rotorit/Adapto/Pictures/AluFrame/20120826_175629.jpg

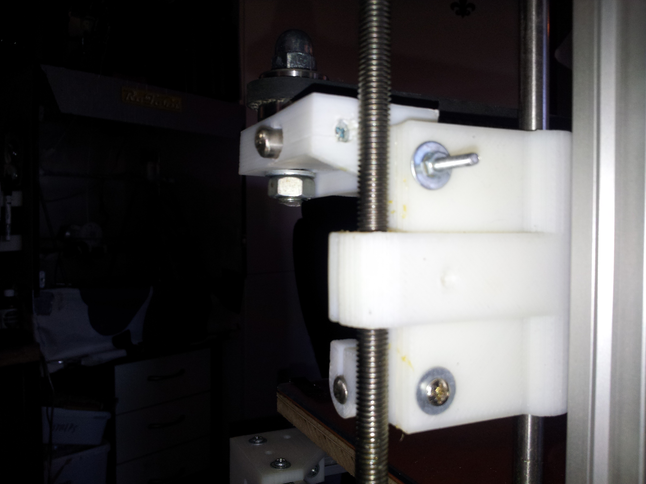
Pictures/AluFrame/20120826_175629.jpg
