rotorit/Adapto/Pictures/WoodenFrame1/20120906_165929.jpg

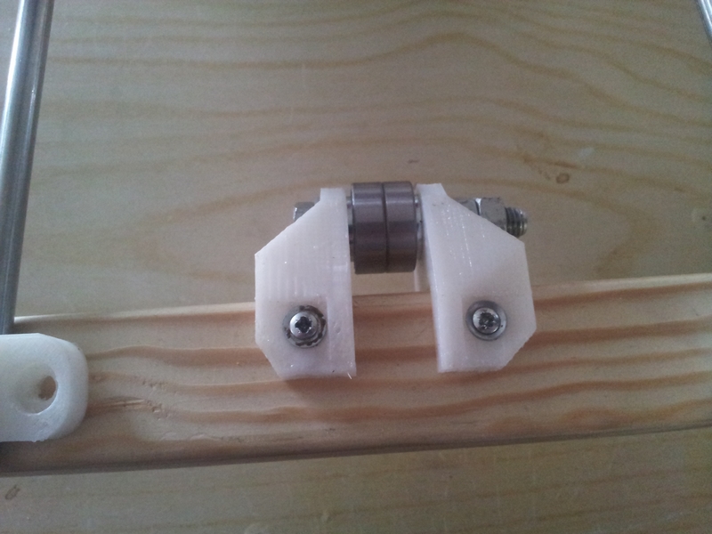
Pictures/WoodenFrame1/20120906_165929.jpg
