rotorit/Adapto/Pictures/AluFrame/20120826_175411.jpg

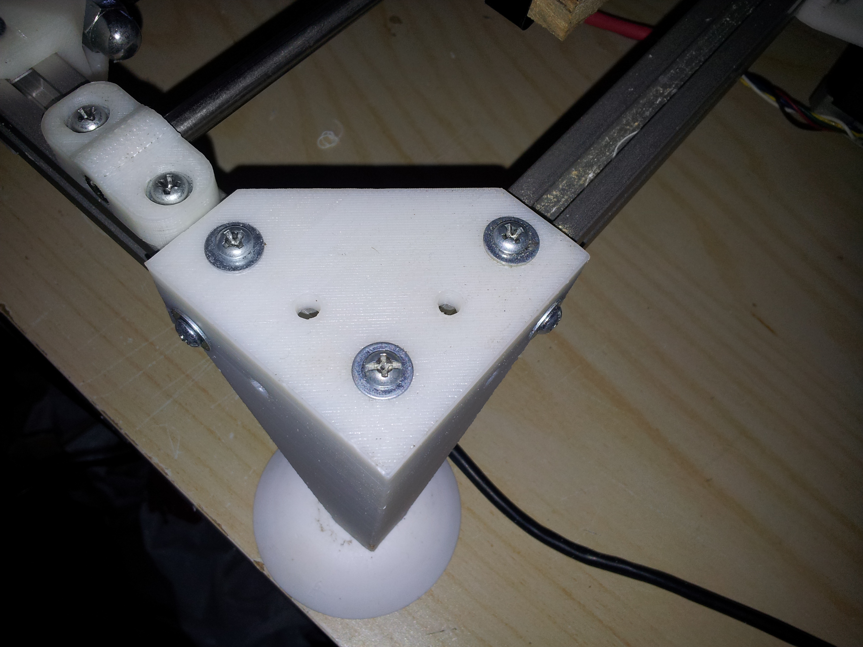
Pictures/AluFrame/20120826_175411.jpg
