rotorit/Adapto/Pictures/AluFrame/20120826_175428.jpg

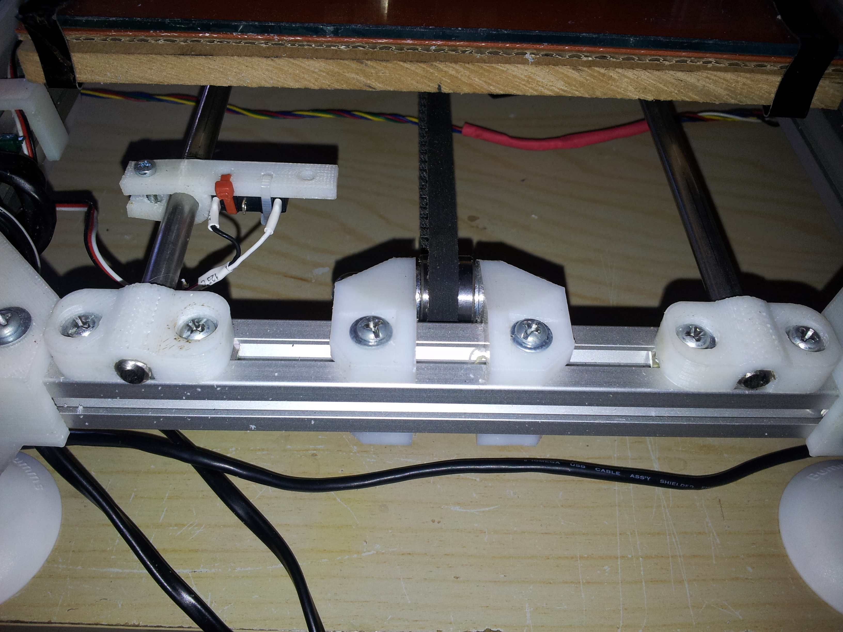
Pictures/AluFrame/20120826_175428.jpg
