rotorit/Adapto/Pictures/AluFrame/20120826_175446.jpg

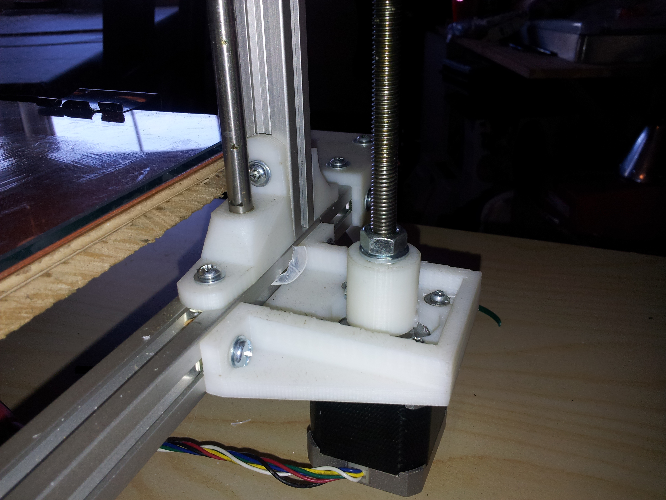
Pictures/AluFrame/20120826_175446.jpg
