rotorit/Adapto/Pictures/AluFrame/20120826_175456.jpg

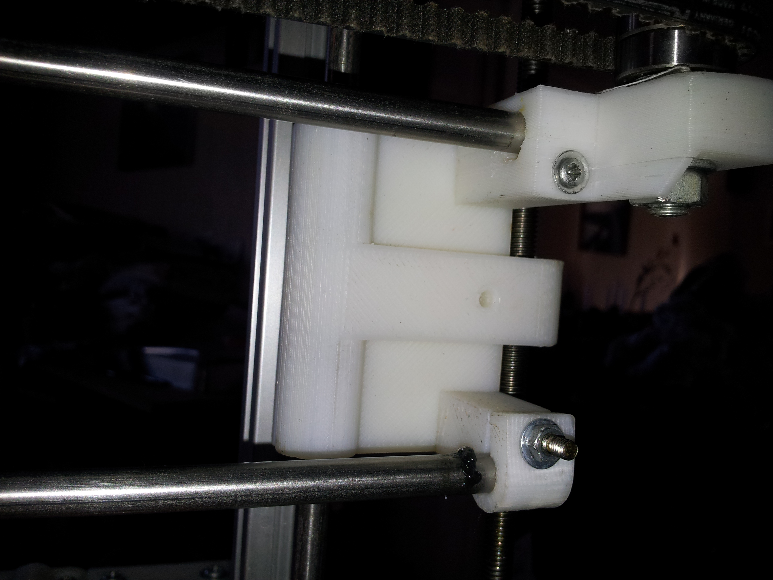
Pictures/AluFrame/20120826_175456.jpg
