rotorit/Adapto/Pictures/AluFrame/20120826_175528.jpg

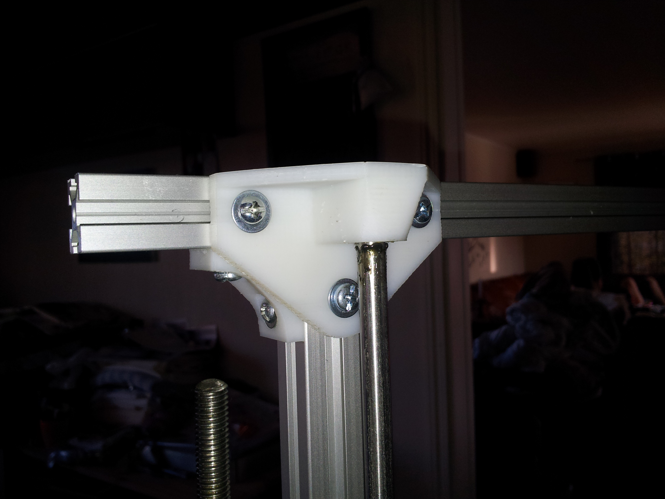
Pictures/AluFrame/20120826_175528.jpg
