rotorit/Adapto/Pictures/AluFrame/20120826_175540.jpg

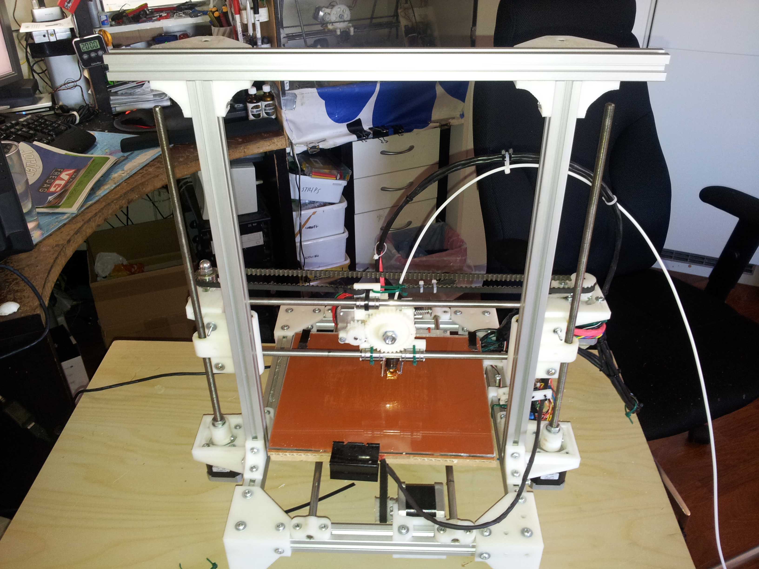
Pictures/AluFrame/20120826_175540.jpg
