rotorit/Adapto/Pictures/AluFrame/20120826_175548.jpg

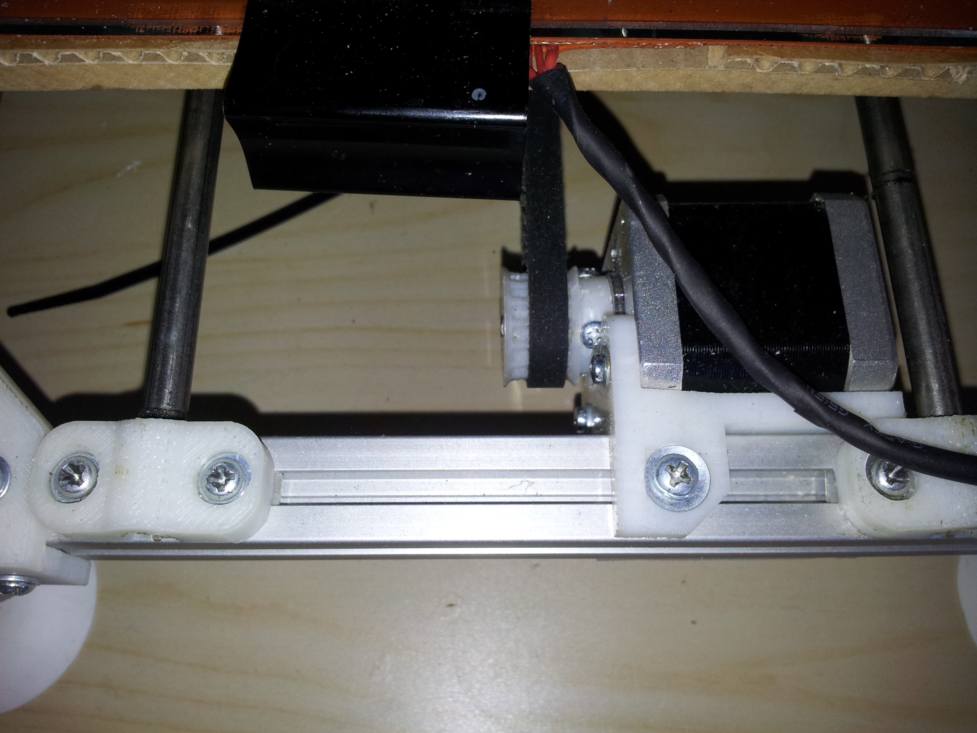
Pictures/AluFrame/20120826_175548.jpg
