rotorit/Adapto/Pictures/AluFrame/20120826_175600.jpg

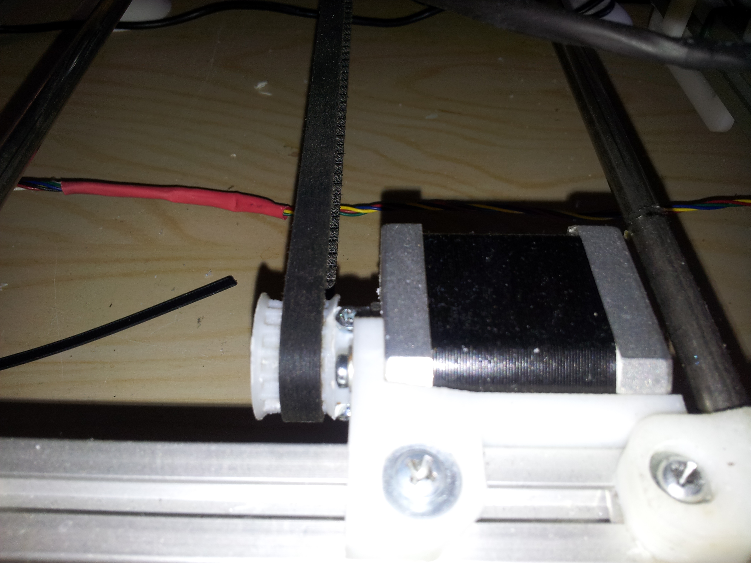
Pictures/AluFrame/20120826_175600.jpg
