rotorit/Adapto/Pictures/AluFrame/20120826_175611.jpg

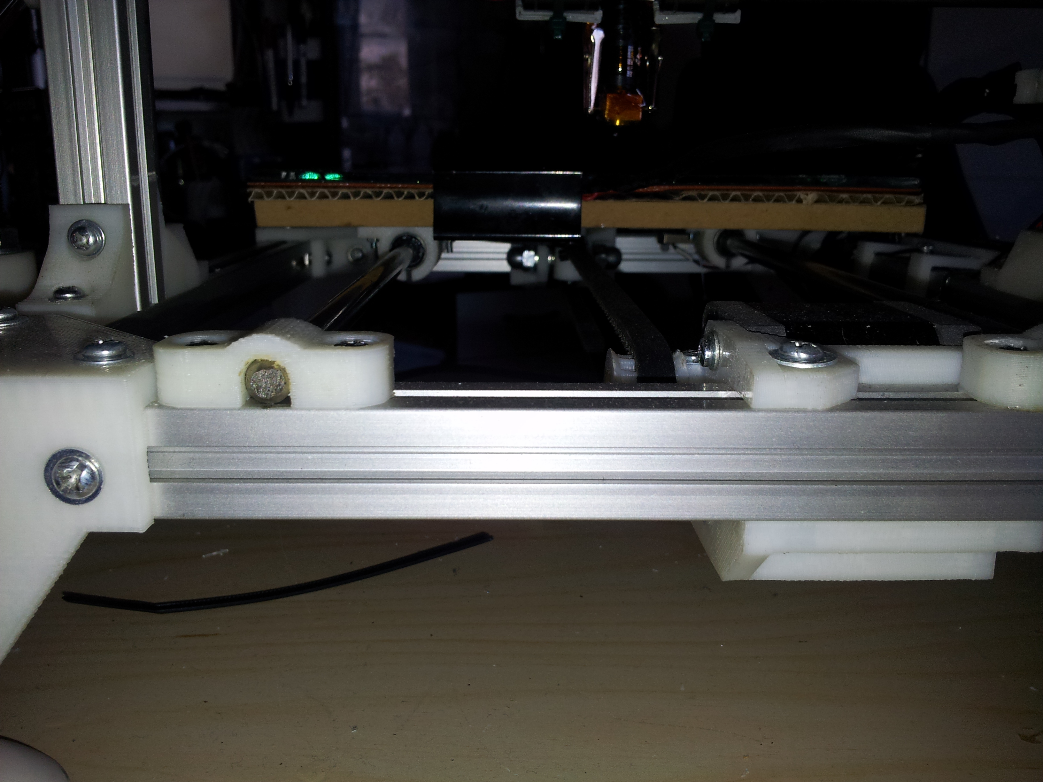
Pictures/AluFrame/20120826_175611.jpg
