rotorit/Adapto/Pictures/AluFrame/20120826_175620.jpg

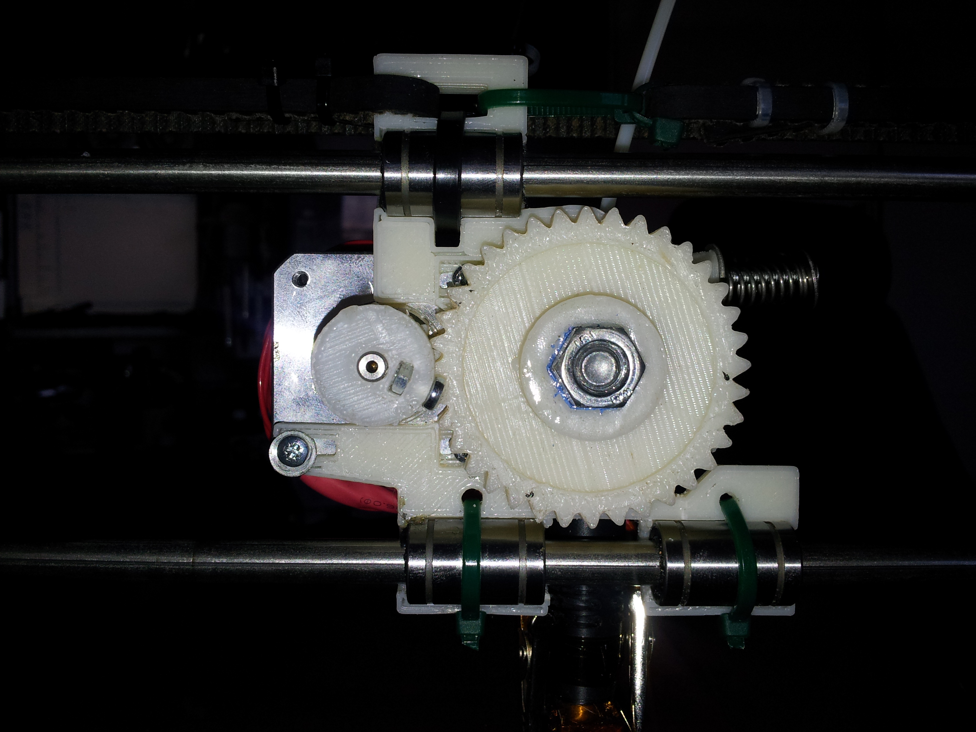
Pictures/AluFrame/20120826_175620.jpg
