rotorit/Adapto/Pictures/AluFrame/20120826_175636.jpg

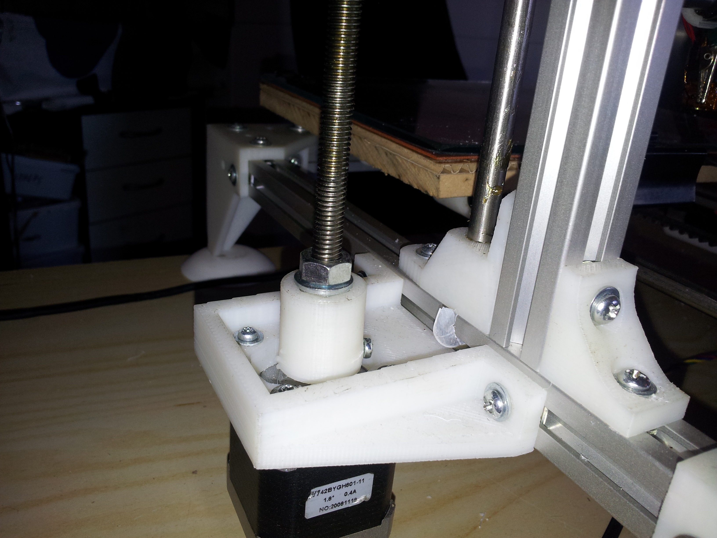
Pictures/AluFrame/20120826_175636.jpg
