rotorit/Adapto/Pictures/AluFrame/20120826_175650.jpg

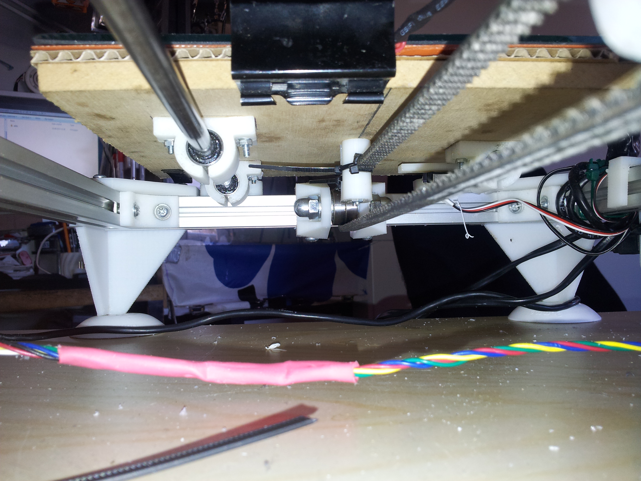
Pictures/AluFrame/20120826_175650.jpg
