rotorit/Adapto/Pictures/AluFrame/20120826_175700.jpg

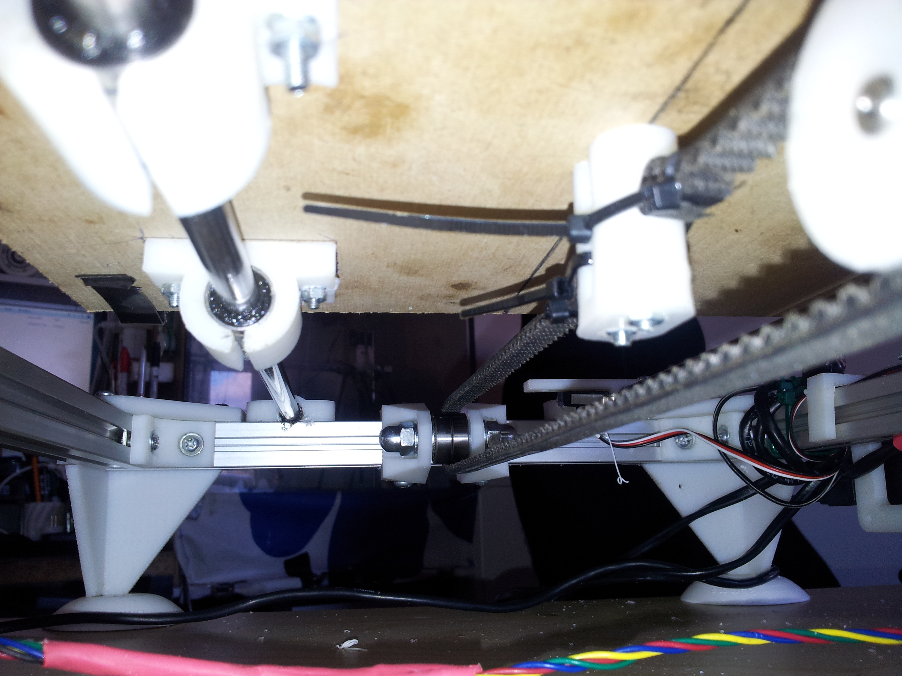
Pictures/AluFrame/20120826_175700.jpg
