rotorit/Adapto/Pictures/AluFrame/20120826_175709.jpg

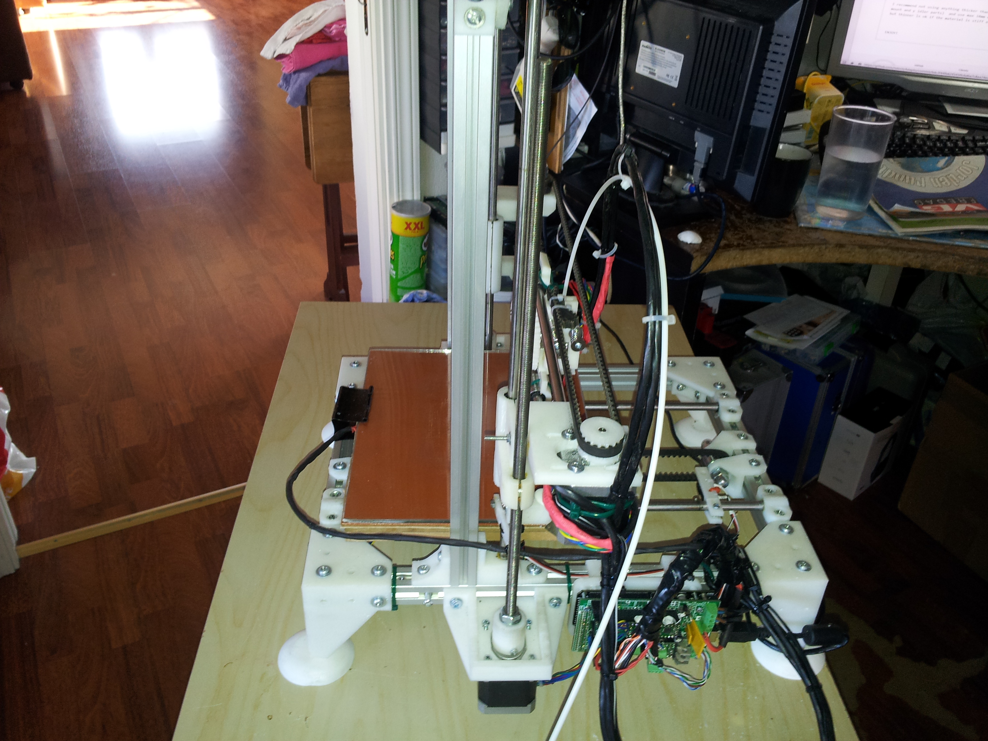
Pictures/AluFrame/20120826_175709.jpg
