rotorit/Adapto/Pictures/AluFrame/20120826_175718.jpg

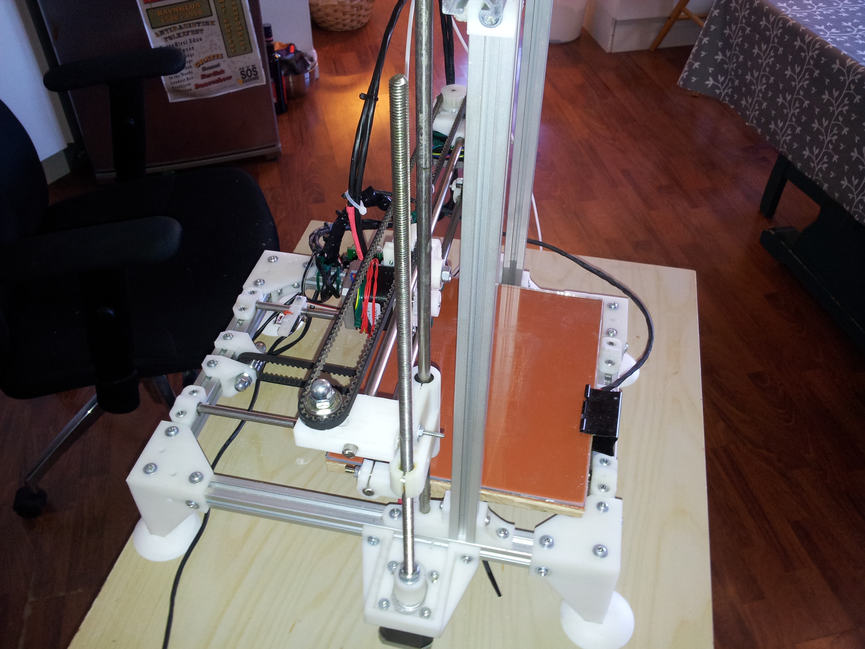
Pictures/AluFrame/20120826_175718.jpg
