rotorit/Adapto/Pictures/AluFrame/20120906_141601.jpg

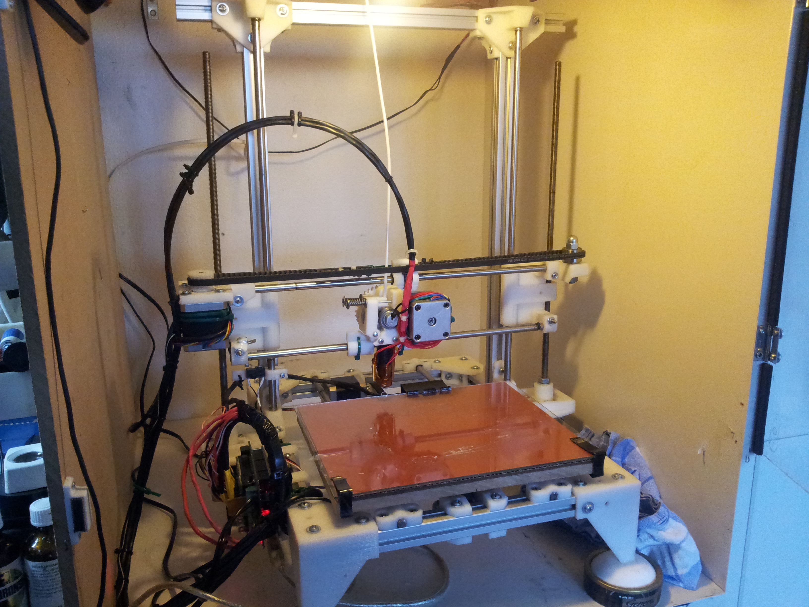
Pictures/AluFrame/20120906_141601.jpg
