rotorit/Adapto/Pictures/WoodenFrame1/20120906_165900.jpg

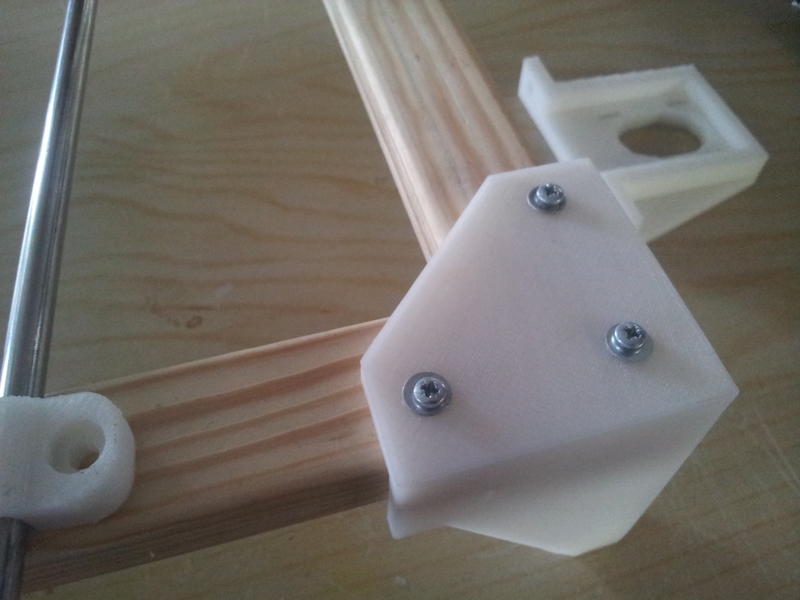
Pictures/WoodenFrame1/20120906_165900.jpg
