rotorit/Adapto/Pictures/WoodenFrame1/20120906_165909.jpg

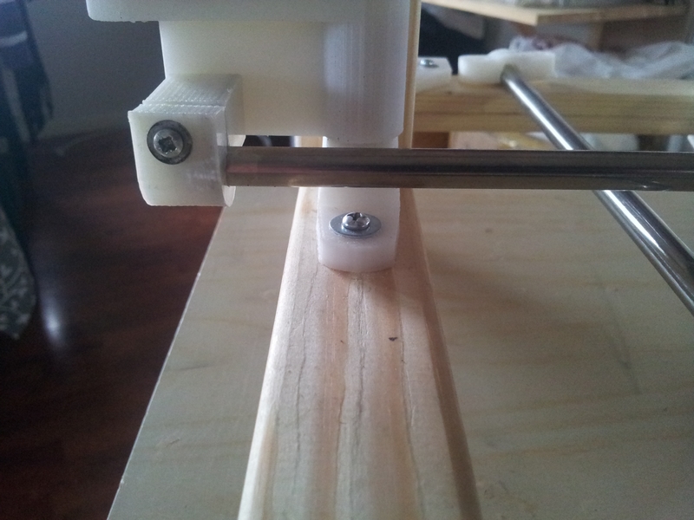
Pictures/WoodenFrame1/20120906_165909.jpg
