rotorit/Adapto/Pictures/WoodenFrame1/20120906_165917.jpg

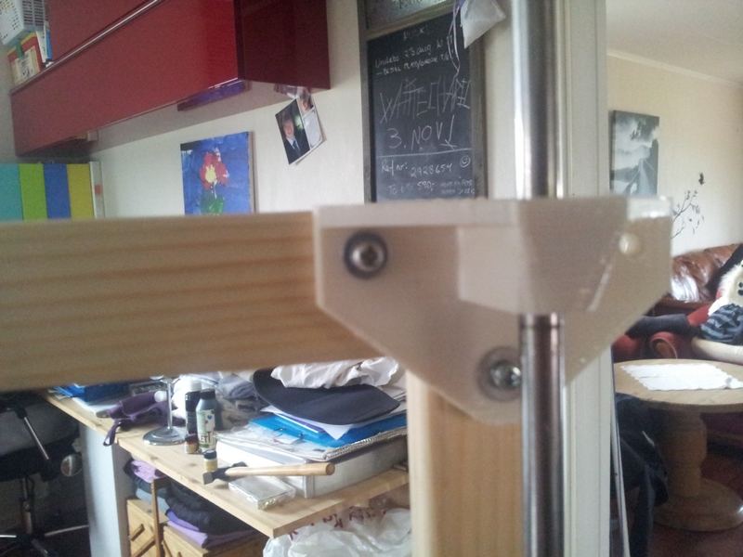
Pictures/WoodenFrame1/20120906_165917.jpg
