rotorit/Adapto/Pictures/WoodenFrame1/20120906_165955.jpg

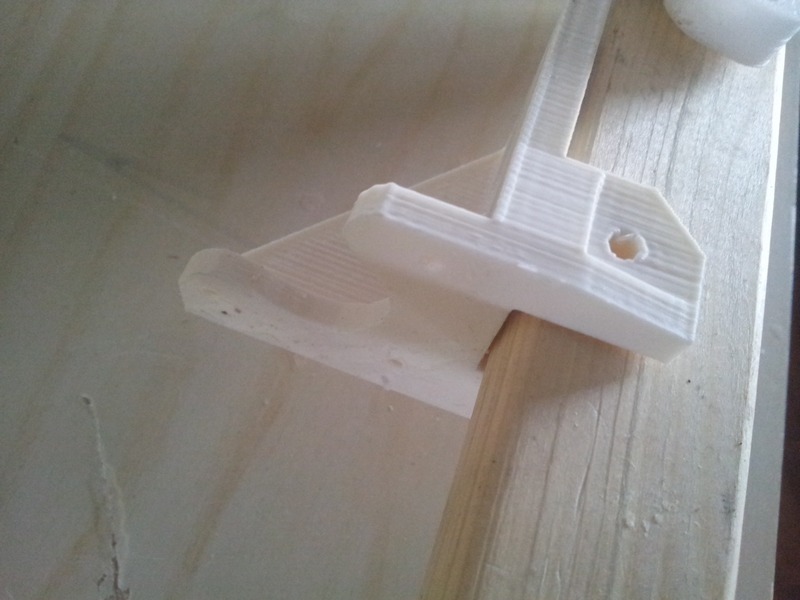
Pictures/WoodenFrame1/20120906_165955.jpg
