rotorit/Adapto/Pictures/WoodenFrame1/20120906_170003.jpg

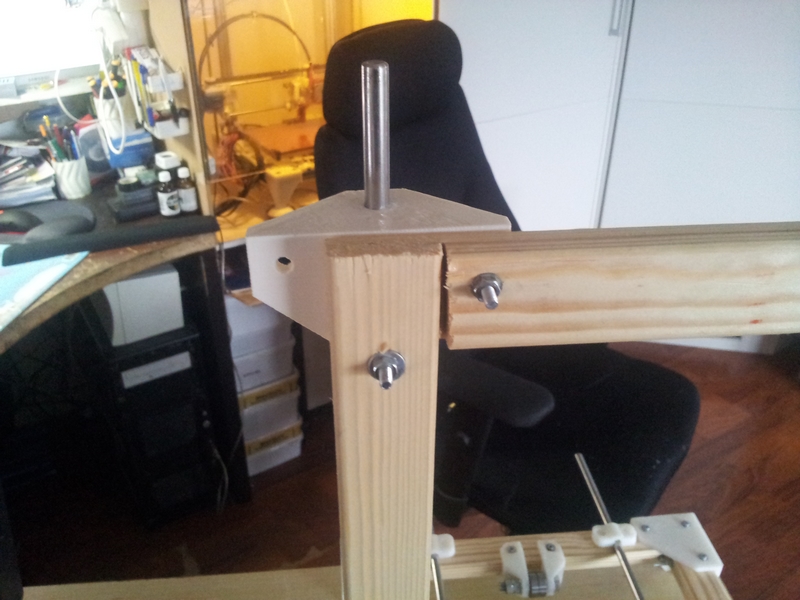
Pictures/WoodenFrame1/20120906_170003.jpg
