rotorit/Adapto/Pictures/WoodenFrame1/20120906_170010.jpg

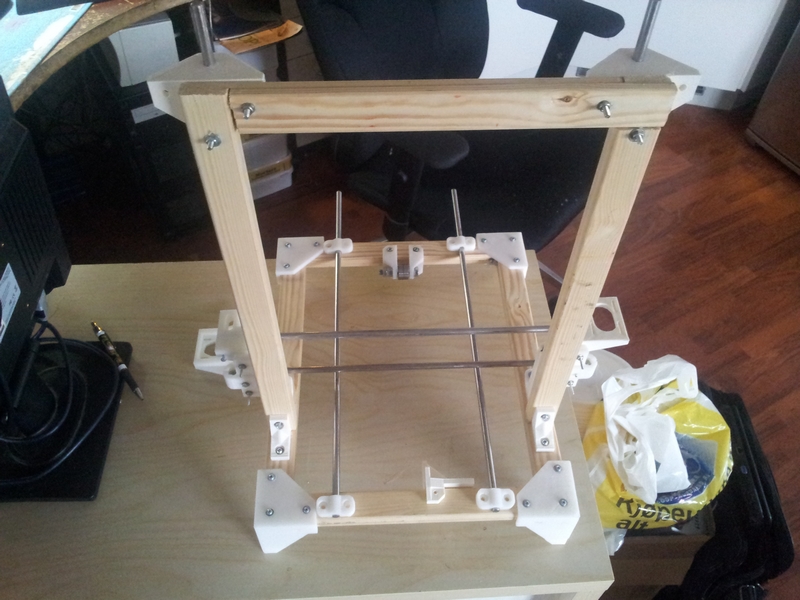
Pictures/WoodenFrame1/20120906_170010.jpg
