rotorit/Adapto/Pictures/WoodenFrame1/20120906_170022.jpg

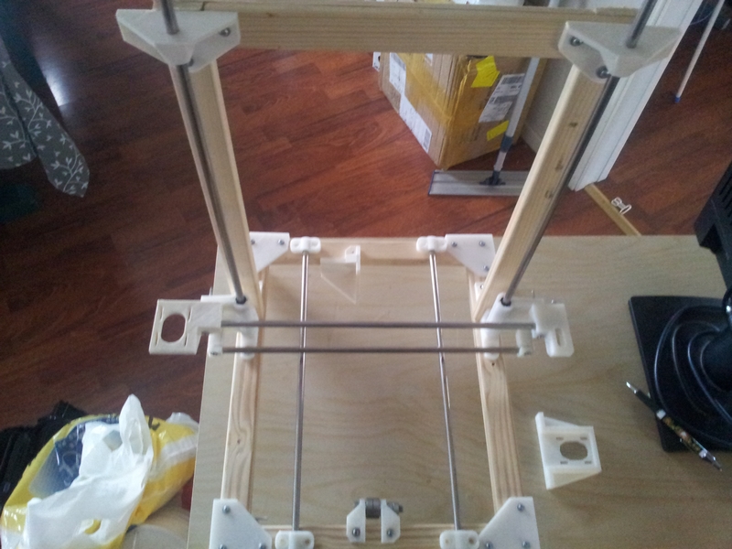
Pictures/WoodenFrame1/20120906_170022.jpg
