rotorit/Adapto/Pictures/WoodenFrame1/20120906_170032.jpg

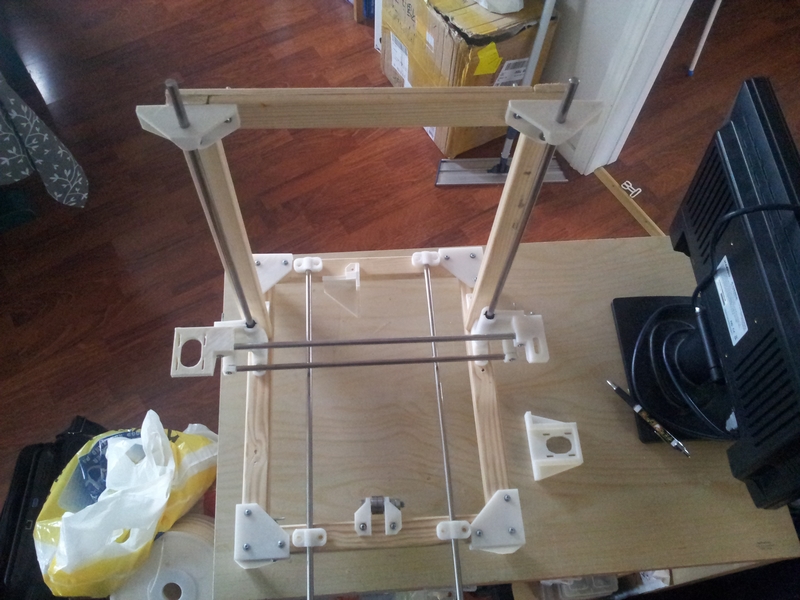
Pictures/WoodenFrame1/20120906_170032.jpg
