rotorit/Adapto/RP_Parts/STLs/Readme.txt

Hers the STLs and these are made in Blender

For STLs made from the SCAD files pleas see in the SCADs folder

The file name tell you how many of it one need to build a printer.
