rotorit/Adapto/Adapto_V_3.0_/10mm/Extruder_X_Carriage_Combo_LM10UU_E3Dv6_and_J-head.STL

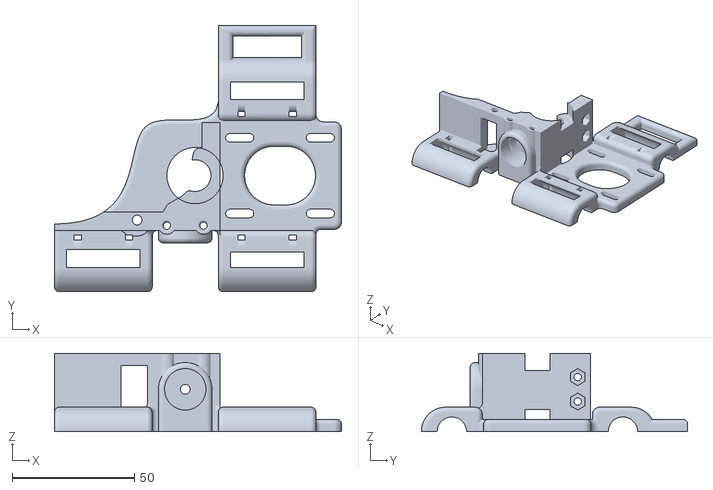
[picture p27: CAD file, 2018-02-04]
Adapto_V_3.0_/10mm/Extruder_X_Carriage_Combo_LM10UU_E3Dv6_and_J-head.STL
117.4 x 109.0 x 32.0
