rotorit/Adapto/Adapto_V_3.0_/8mm/Y_Rod_Clamp_8mm_4_Off.STL

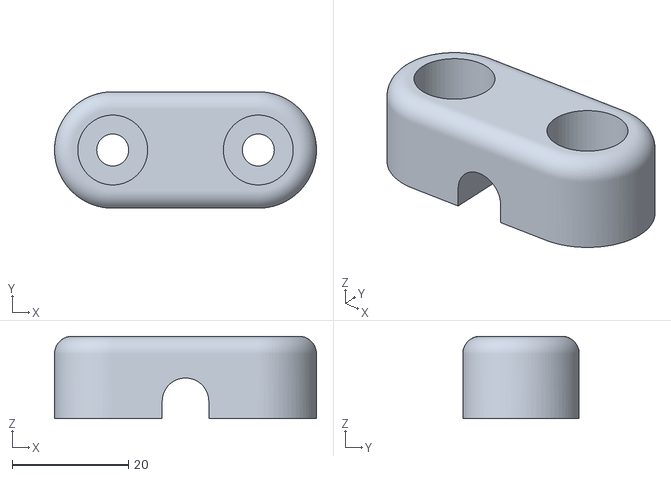
[picture p28: CAD file, 2014-10-25]
Adapto_V_3.0_/8mm/Y_Rod_Clamp_8mm_4_Off.STL
45.0 x 20.0 x 14.2
