rotorit/Adapto/Adapto_V_3.0_/SourceFiles/SoldWorks .sldprt/Extruder_X_Carriage_Combo_LM10UU.SLDPRT

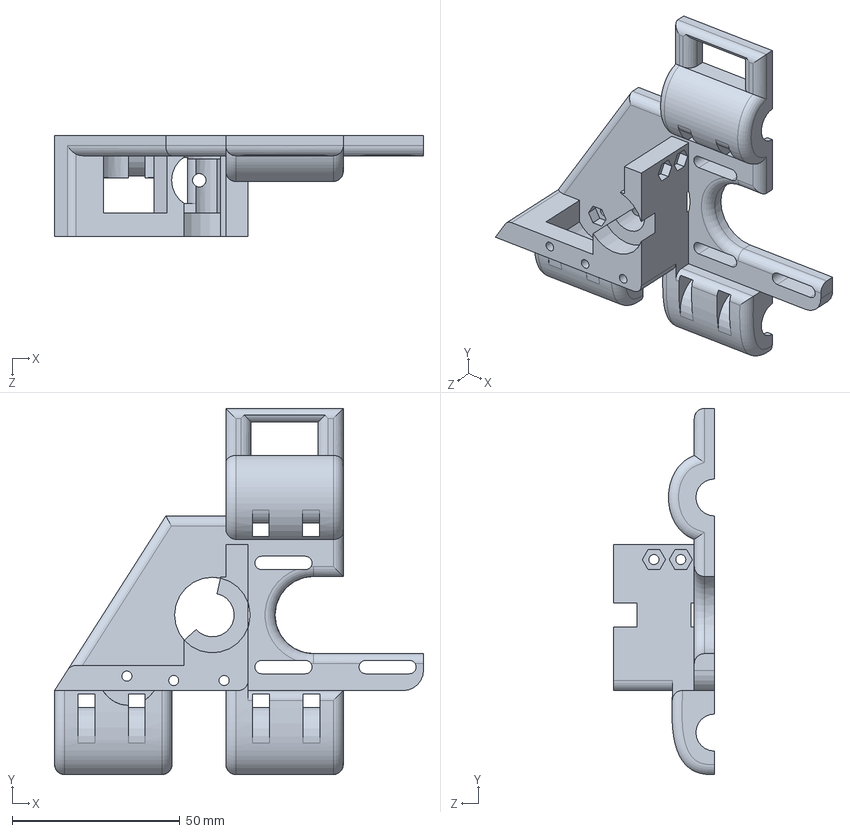
[picture p29: CAD file, 2016-01-17]
Adapto_V_3.0_/SourceFiles/SoldWorks .sldprt/Extruder_X_Carriage_Combo_LM10UU.SLDPRT
109.9 x 109.0 x 30.0 mm
