rotorit/Adapto/Jasons Mods/Ekstruder_X_Carriage_LM10UU_E3D-V6-Universal.stl

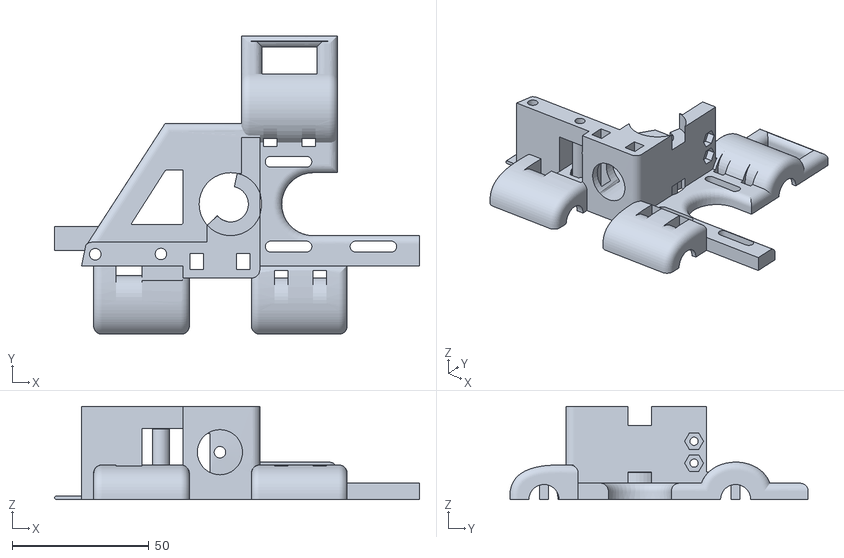
[picture p30: CAD file, 2016-01-04]
Jasons Mods/Ekstruder_X_Carriage_LM10UU_E3D-V6-Universal.stl
133.3 x 109.0 x 34.0
