rotorit/Adapto/RP_Parts/SCADs/SCAD_STLs/foot_4_off.stl

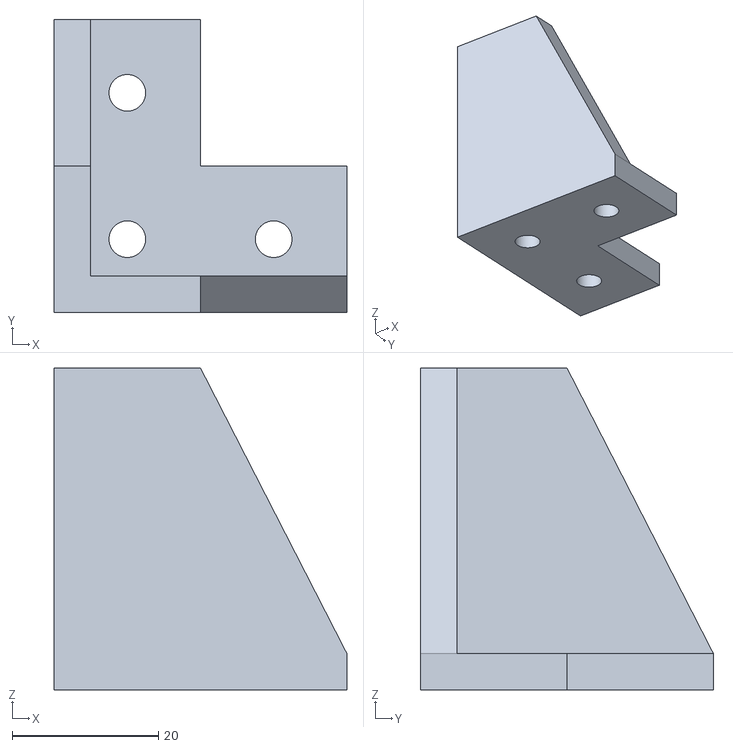
[picture p31: CAD file, 2013-07-14]
RP_Parts/SCADs/SCAD_STLs/foot_4_off.stl
40.0 x 40.0 x 44.0
