rotorit/Adapto/RP_Parts/SolidWorks/Source/Y_Rod_Clamp_4_Off.SLDPRT

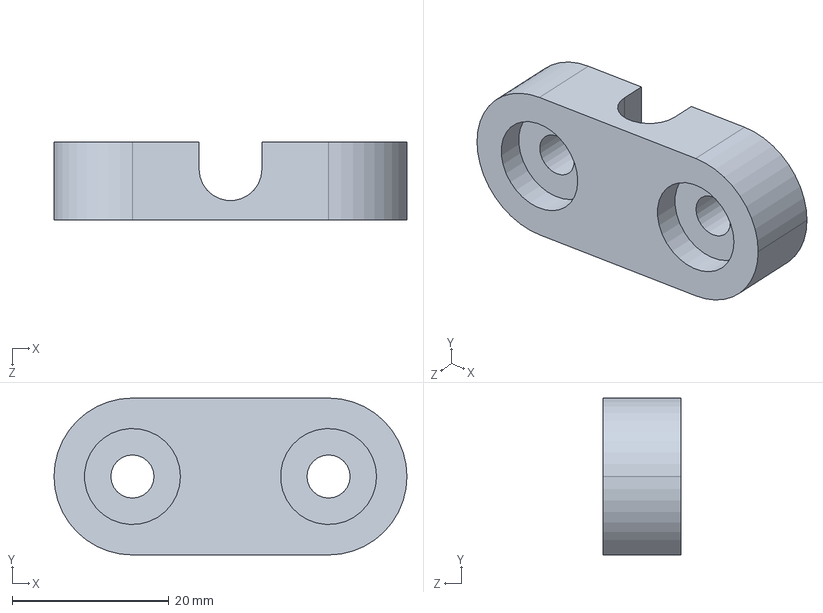
[picture p32: CAD file, 2013-07-14]
RP_Parts/SolidWorks/Source/Y_Rod_Clamp_4_Off.SLDPRT
45.0 x 20.0 x 10.0 mm
