rotorit/Adapto/RP_Parts/STLs/10mm/10mm_Y_Rod_Clamp_4_Off.stl

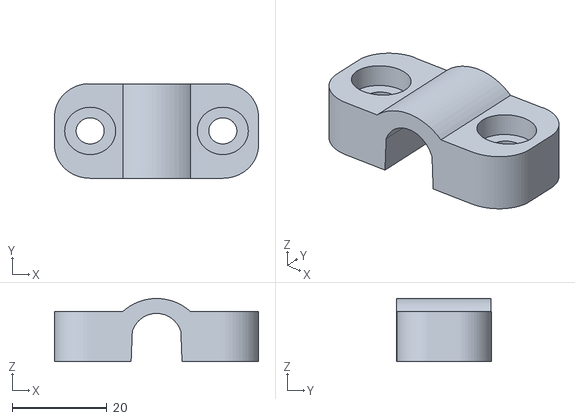
[picture p33: CAD file, 2014-06-02]
RP_Parts/STLs/10mm/10mm_Y_Rod_Clamp_4_Off.stl
43.1 x 20.0 x 13.3
