rotorit/Adapto/RP_Parts/STLs/8mm/Z_Smooth_Rod_Holder_Upper_2_Off.stl

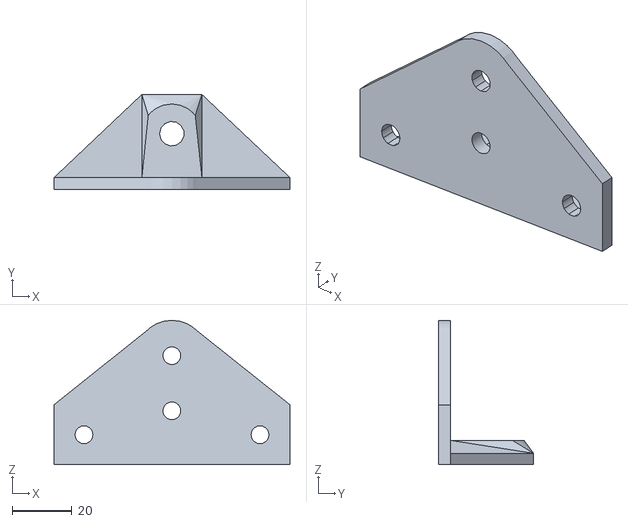
[picture p34: CAD file, 2012-12-31]
RP_Parts/STLs/8mm/Z_Smooth_Rod_Holder_Upper_2_Off.stl
78.7 x 31.8 x 48.2
