rotorit/Adapto/RP_Parts/STLs/alt_RP_Parts_For_20z20_Alu_Spesial/Y_Idler_1_Off.stl

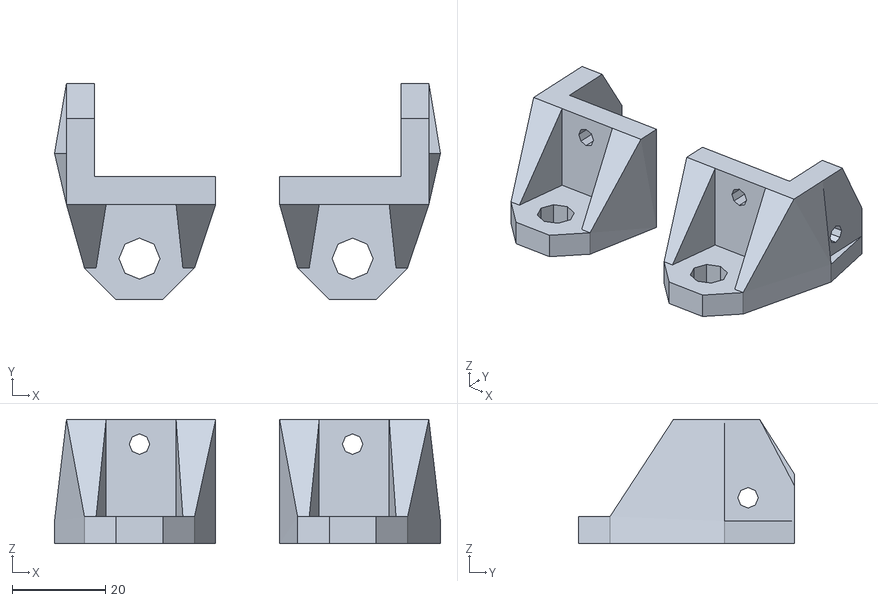
[picture p35: CAD file, 2012-11-11]
RP_Parts/STLs/alt_RP_Parts_For_20z20_Alu_Spesial/Y_Idler_1_Off.stl
82.8 x 46.4 x 26.6
