rotorit/Adapto/RP_Parts/STLs/Extruder_Idler_1_Off.stl

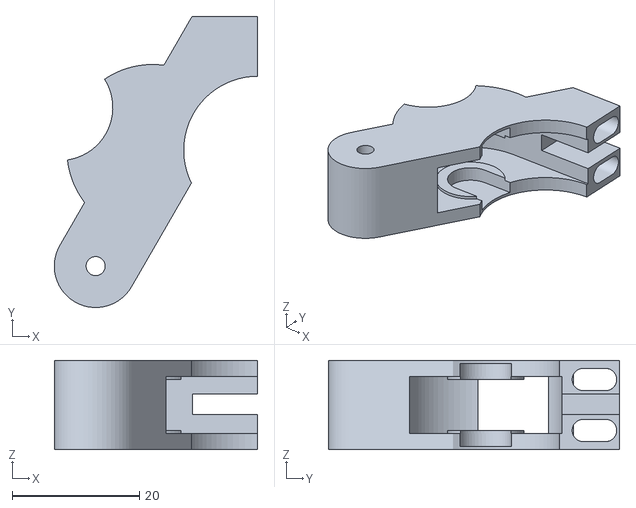
[picture p36: CAD file, 2014-09-11]
RP_Parts/STLs/Extruder_Idler_1_Off.stl
31.9 x 45.7 x 14.0
