rotorit/Adapto/RP_Parts/STLs/OPTIONAL/Extruder_Idler_splitted_for_easier_printing_optional_1_off.STL

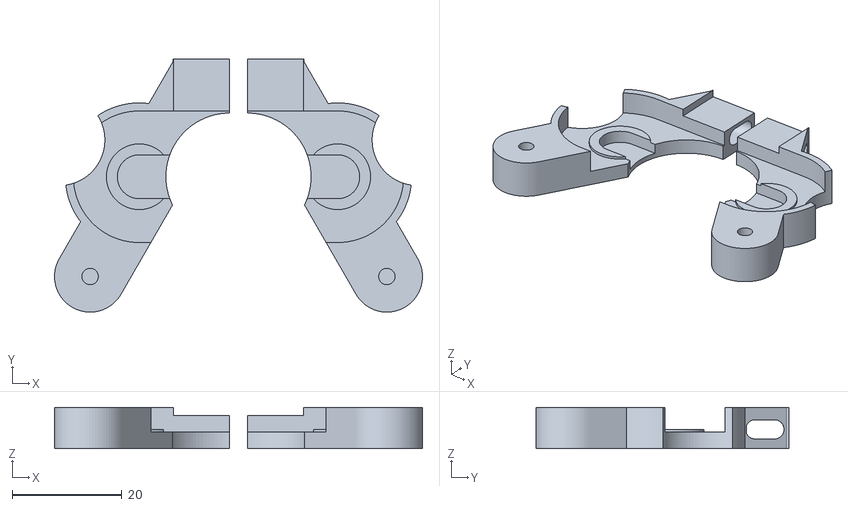
[picture p37: CAD file, 2014-09-11]
RP_Parts/STLs/OPTIONAL/Extruder_Idler_splitted_for_easier_printing_optional_1_off.STL
67.1 x 46.2 x 7.50
