rotorit/Adapto/Jasons Mods/10mm_Z_Smooth_Rod_Holder_Upper_Left.stl

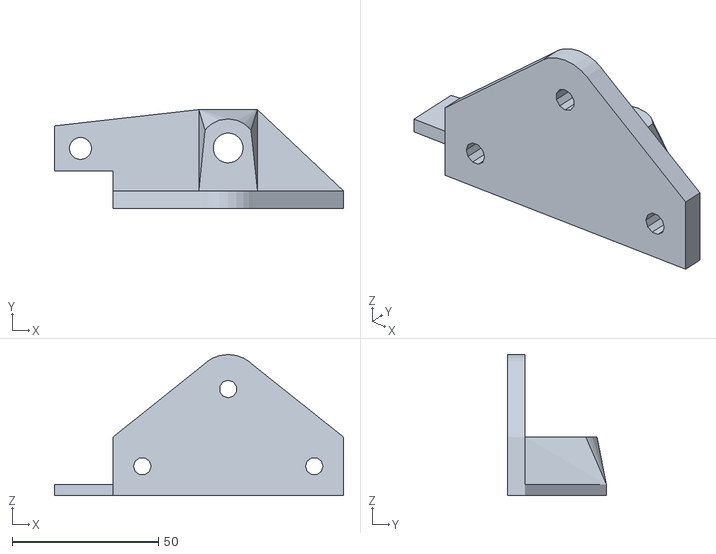
[picture p38: CAD file, 2015-08-21]
Jasons Mods/10mm_Z_Smooth_Rod_Holder_Upper_Left.stl
98.7 x 33.8 x 48.2
