rotorit/Adapto/RP_Parts/STLs/8mm/Z_Smooth_Rod_Holder_Lower_2_Off.stl

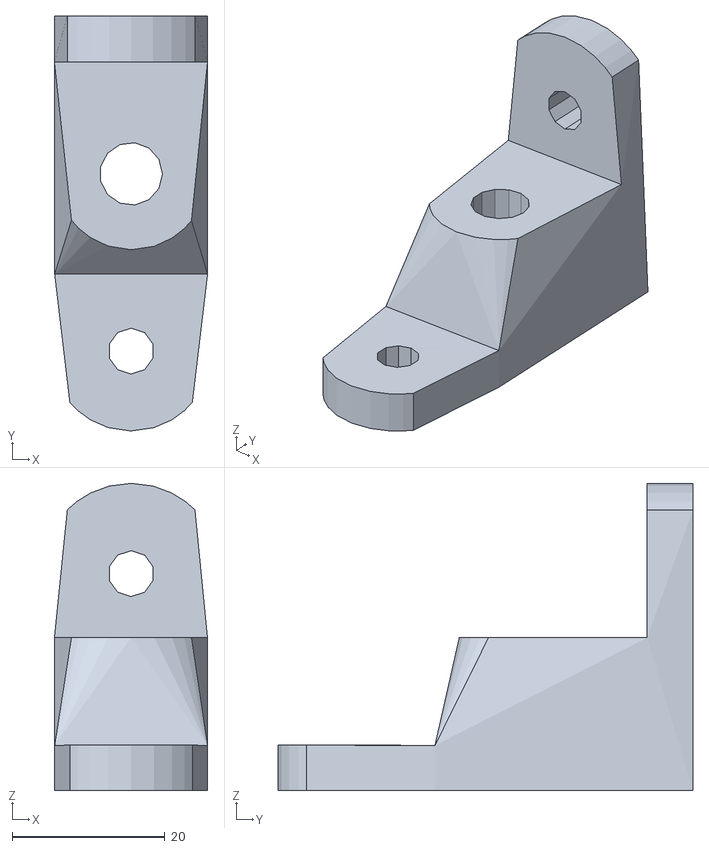
[picture p39: CAD file, 2012-08-26]
RP_Parts/STLs/8mm/Z_Smooth_Rod_Holder_Lower_2_Off.stl
20.0 x 54.3 x 40.2
