rotorit/Adapto/RP_Parts/STLs/Extruder_X_Carriage_Combo_LM8UU_1_off.STL

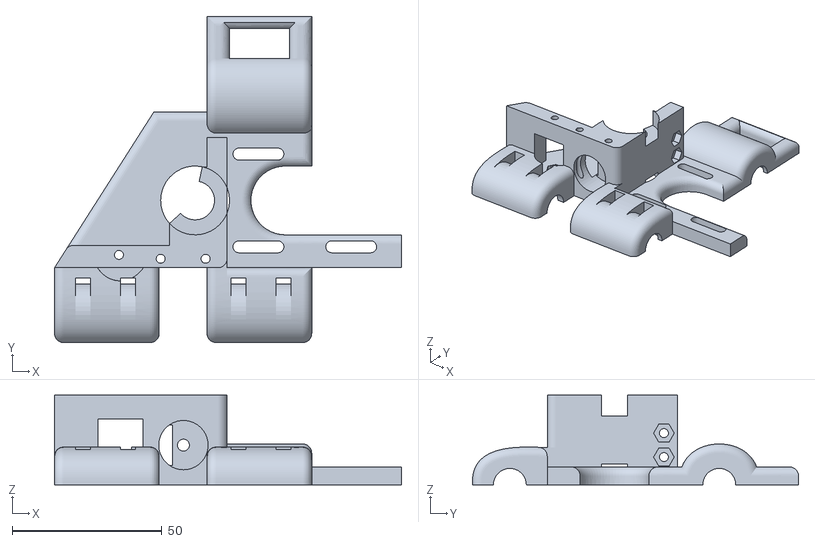
[picture p41: CAD file, 2014-09-11]
RP_Parts/STLs/Extruder_X_Carriage_Combo_LM8UU_1_off.STL
116.0 x 109.0 x 30.0
