rotorit/Adapto/Adapto_V_3.0_/M6 optional/Z_Couplers_For_M6_and_M5_Nuts.stl

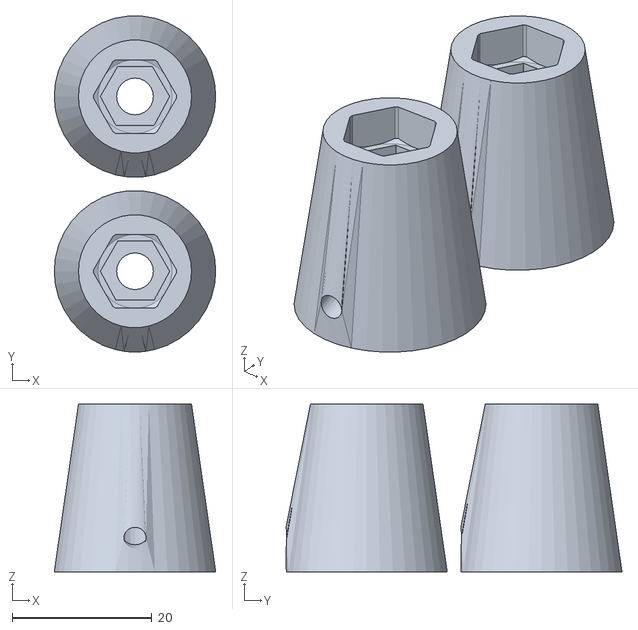
[picture p42: CAD file, 2013-07-14]
Adapto_V_3.0_/M6 optional/Z_Couplers_For_M6_and_M5_Nuts.stl
23.1 x 48.1 x 24.0
