rotorit/Adapto/RP_Parts/STLs/10mm/Gears_33_11.stl

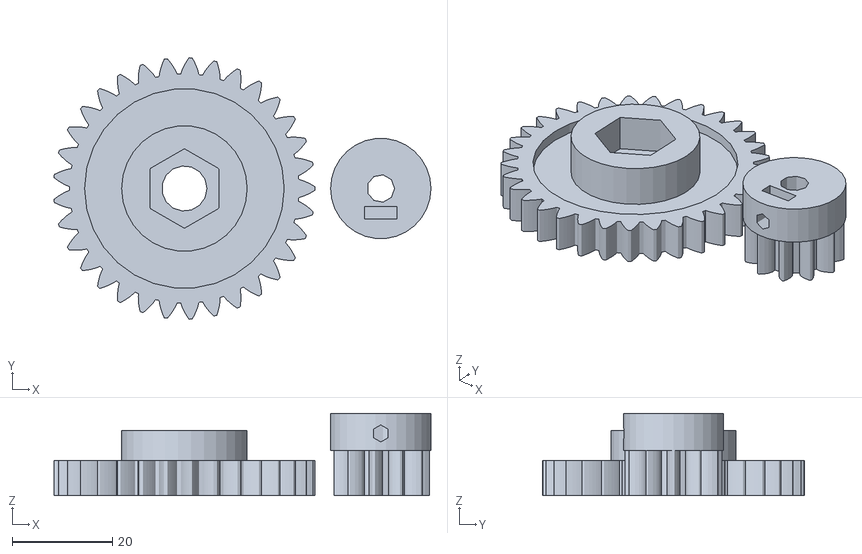
[picture p43: CAD file, 2013-09-12]
RP_Parts/STLs/10mm/Gears_33_11.stl
75.1 x 52.1 x 16.4
