rotorit/Adapto/RP_Parts/STLs/alt_RP_Parts_For_20z20_Alu_Spesial/Y_Motor_Mount_1_Off_For_20mm_Thick_Extrisions_or_plates_only.stl

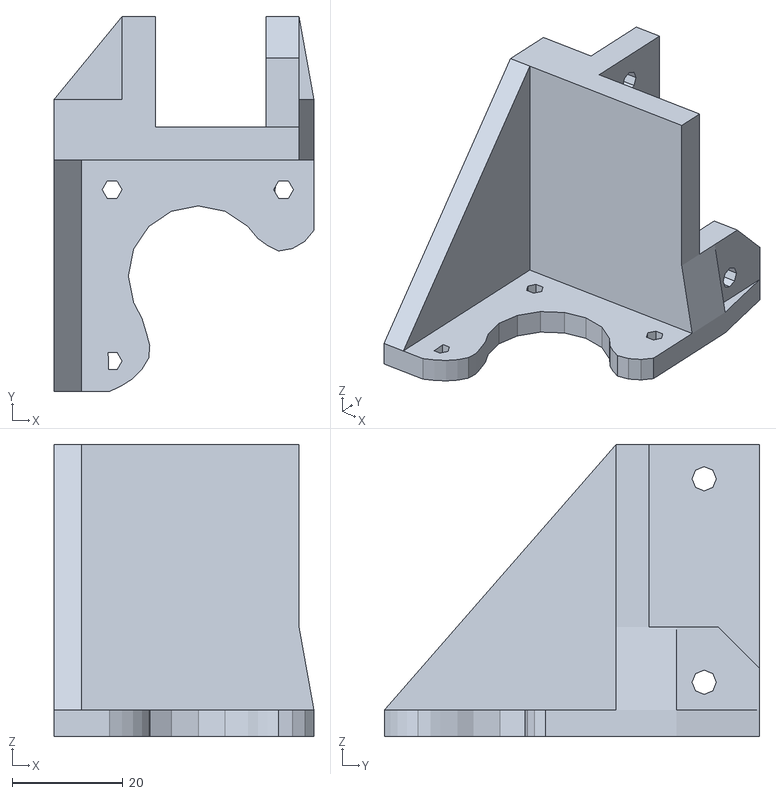
[picture p44: CAD file, 2012-09-14]
RP_Parts/STLs/alt_RP_Parts_For_20z20_Alu_Spesial/Y_Motor_Mount_1_Off_For_20mm_Thick_Extrisions_or_plates_only.stl
47.0 x 67.8 x 52.8
