rotorit/Adapto/RP_Parts/STLs/Y_Bearing_Holder_LM8UU_3_Off.stl

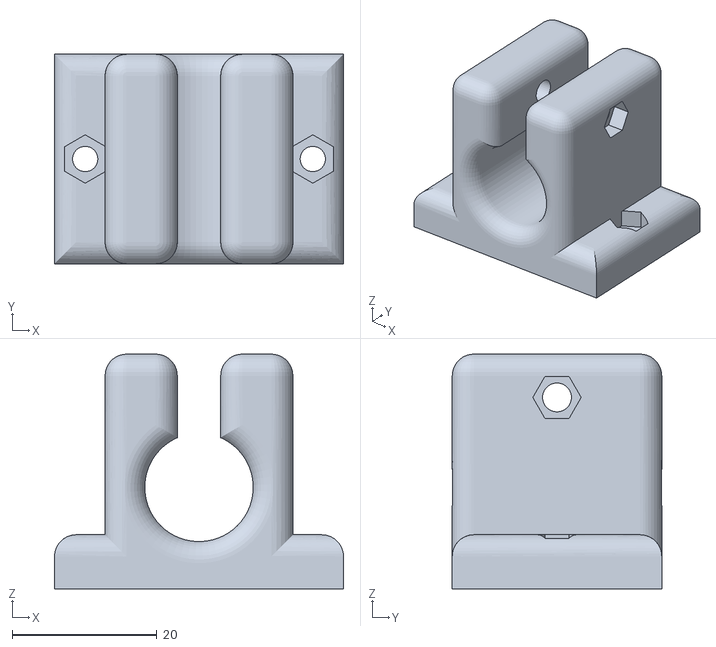
[picture p45: CAD file, 2014-05-16]
RP_Parts/STLs/Y_Bearing_Holder_LM8UU_3_Off.stl
40.0 x 29.0 x 32.5
