rotorit/Adapto/Jasons Mods/Extruder_Hotend_Mount_for_E3D_X_Carriage.stl

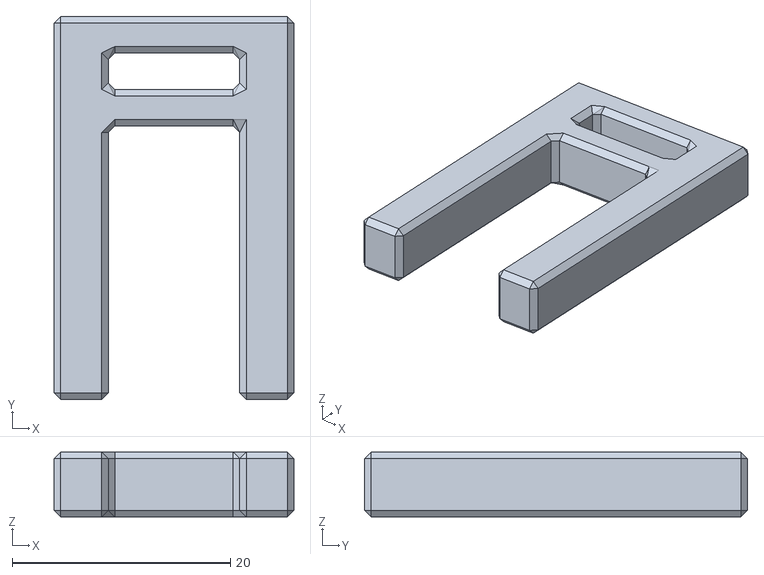
[picture p46: CAD file, 2015-08-21]
Jasons Mods/Extruder_Hotend_Mount_for_E3D_X_Carriage.stl
22.0 x 35.1 x 5.95
