rotorit/Adapto/RP_Parts/STLs/10mm/EndStop_Holder_For_10mm_SmoothReods.STL

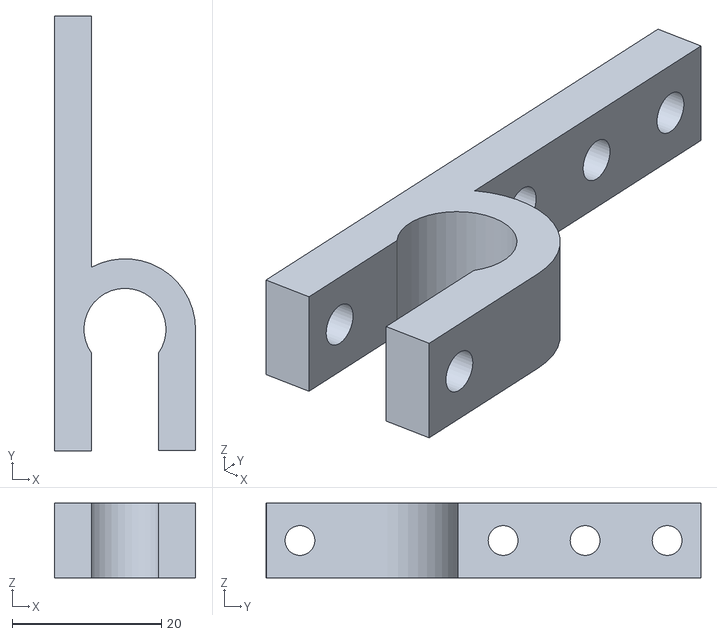
[picture p47: CAD file, 2013-09-12]
RP_Parts/STLs/10mm/EndStop_Holder_For_10mm_SmoothReods.STL
18.9 x 58.4 x 10.0
