rotorit/Adapto/RP_Parts/STLs/ADAPTO.stl

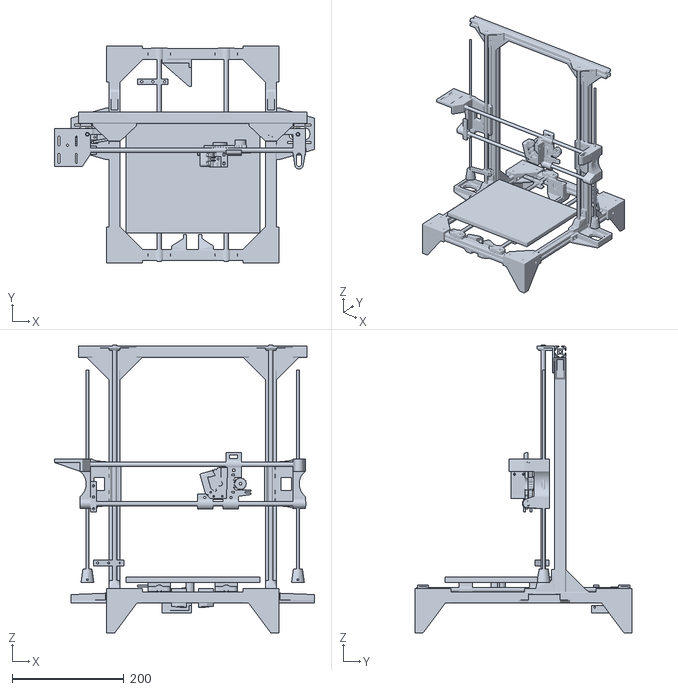
[picture p48: CAD file, 2014-05-16]
RP_Parts/STLs/ADAPTO.stl
465.7 x 389.4 x 515.8
