rotorit/Adapto/Jasons Mods/12mm_Prox_Sensor_Mount.stl

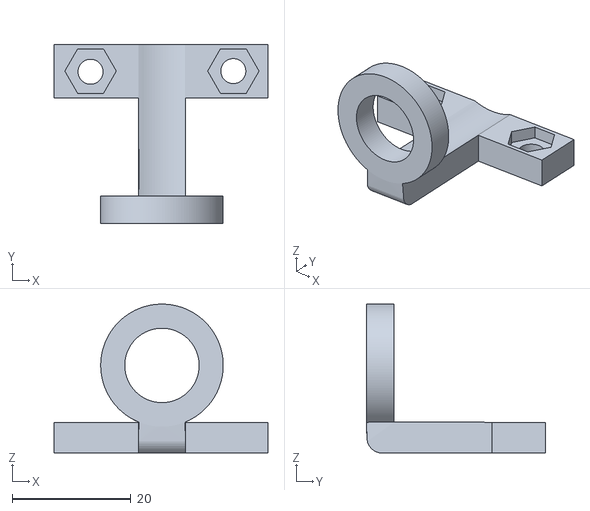
[picture p49: CAD file, 2015-08-21]
Jasons Mods/12mm_Prox_Sensor_Mount.stl
36.0 x 30.2 x 25.0
