rotorit/Adapto/RP_Parts/STLs/10mm/Large_Gear_33T_For_Ekstruder_X_Carriage_LM10UU.stl

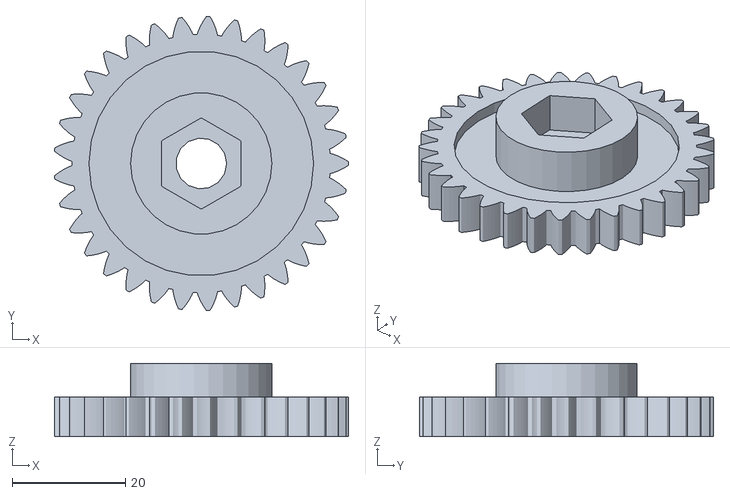
[picture p50: CAD file, 2013-09-12]
RP_Parts/STLs/10mm/Large_Gear_33T_For_Ekstruder_X_Carriage_LM10UU.stl
52.0 x 52.1 x 13.0
