rotorit/Adapto/RP_Parts/STLs/X_End_Motor_1_Off.stl

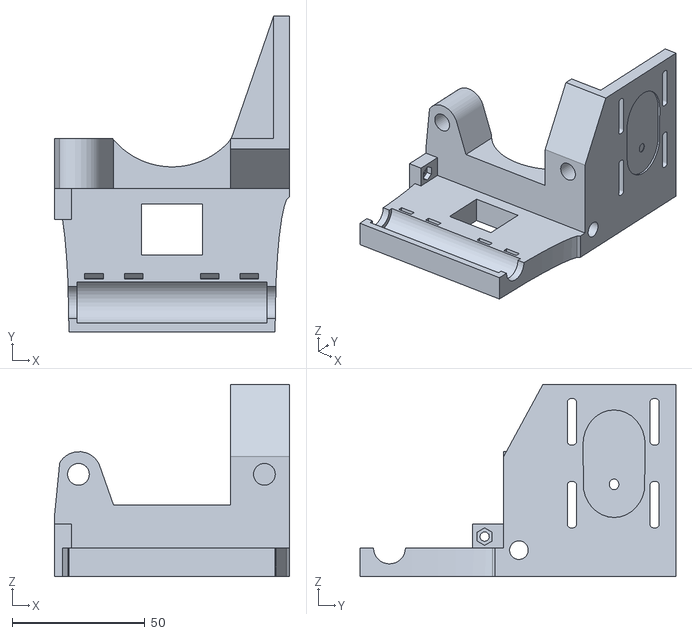
[picture p51: CAD file, 2013-08-26]
RP_Parts/STLs/X_End_Motor_1_Off.stl
88.5 x 118.8 x 72.4
