rotorit/Adapto/Jasons Mods/Y Belt Holder_ABS.stl

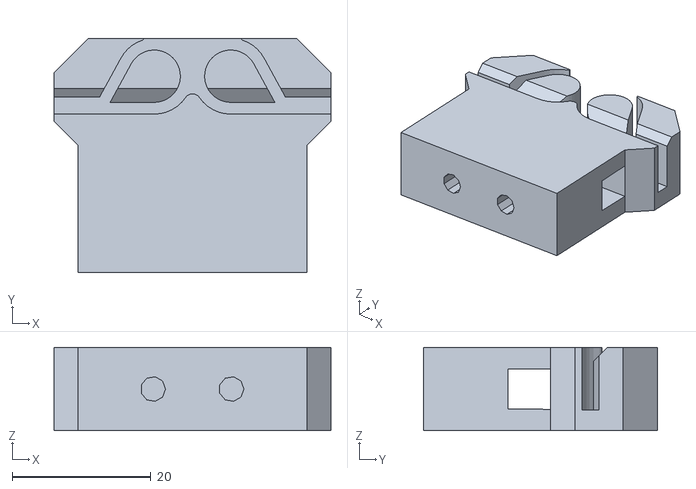
[picture p52: CAD file, 2015-06-19]
Jasons Mods/Y Belt Holder_ABS.stl
40.0 x 33.9 x 12.0
