rotorit/Adapto/RP_Parts/STLs/10mm/X_End_Motor_LM10UU_M5_1_Off.stl

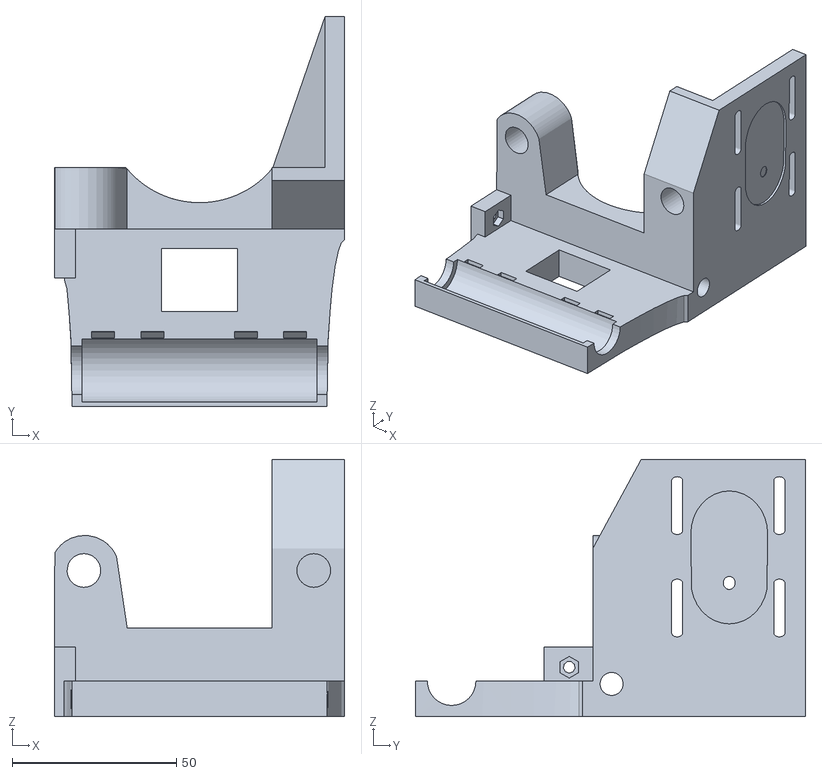
[picture p53: CAD file, 2013-09-12]
RP_Parts/STLs/10mm/X_End_Motor_LM10UU_M5_1_Off.stl
88.5 x 118.8 x 78.4
