rotorit/Adapto/Jasons Mods/18mm_Prox_Sensor_Mount.stl

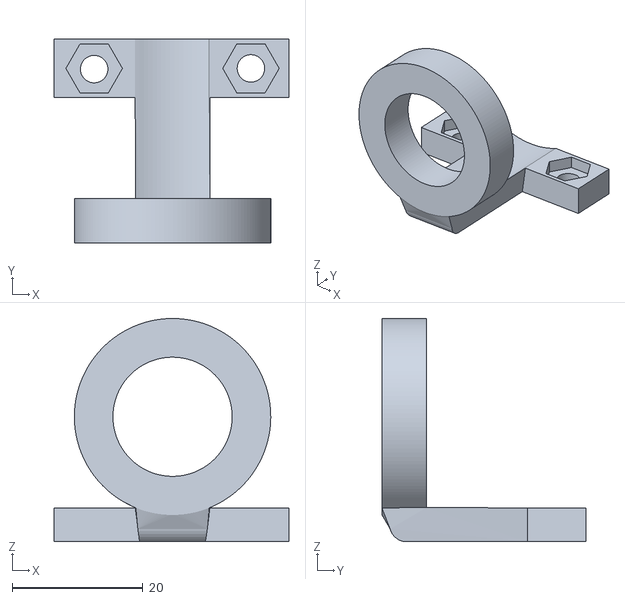
[picture p54: CAD file, 2015-06-19]
Jasons Mods/18mm_Prox_Sensor_Mount.stl
36.0 x 31.3 x 34.1
