rotorit/Adapto/RP_Parts/STLs/10mm/X_End_Idler_LM10UU_M5_1_Off.stl

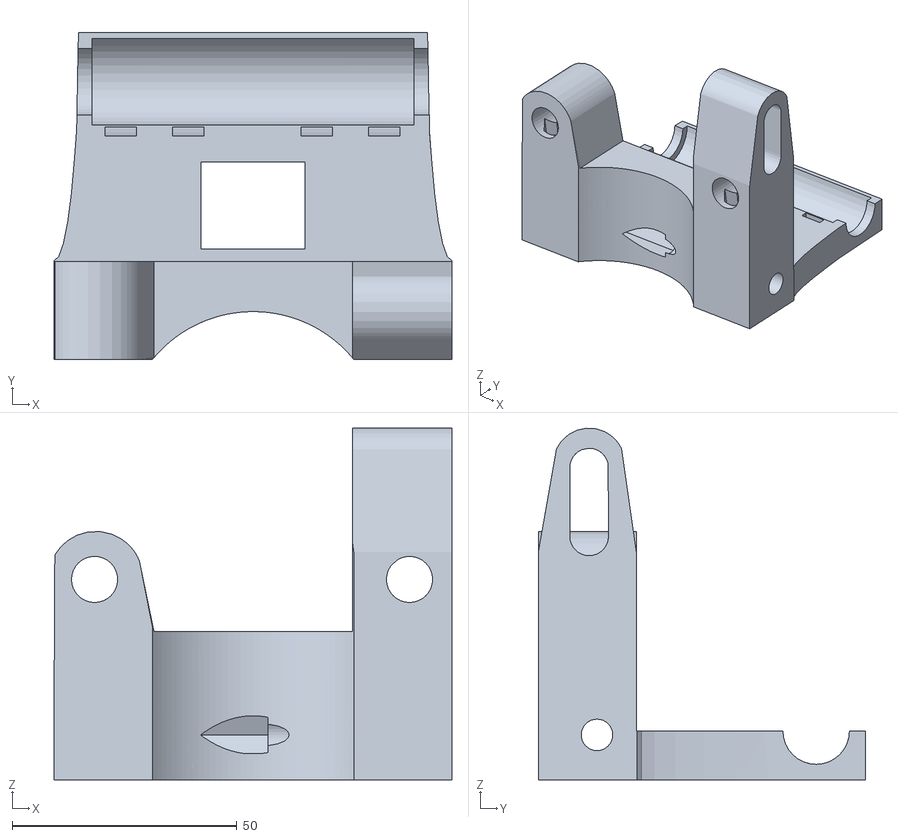
[picture p55: CAD file, 2013-09-12]
RP_Parts/STLs/10mm/X_End_Idler_LM10UU_M5_1_Off.stl
88.5 x 72.8 x 78.1
