rotorit/Adapto/RP_Parts/STLs/Endstop_Holders_X_3.stl

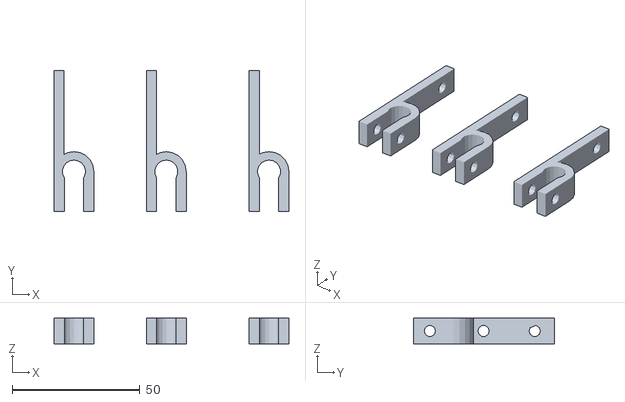
[picture p56: CAD file, 2013-01-13]
RP_Parts/STLs/Endstop_Holders_X_3.stl
91.8 x 54.9 x 10.0
