rotorit/Adapto/Jasons Mods/Extruder_Idler_for_Ekstruder_X_Carriage.stl

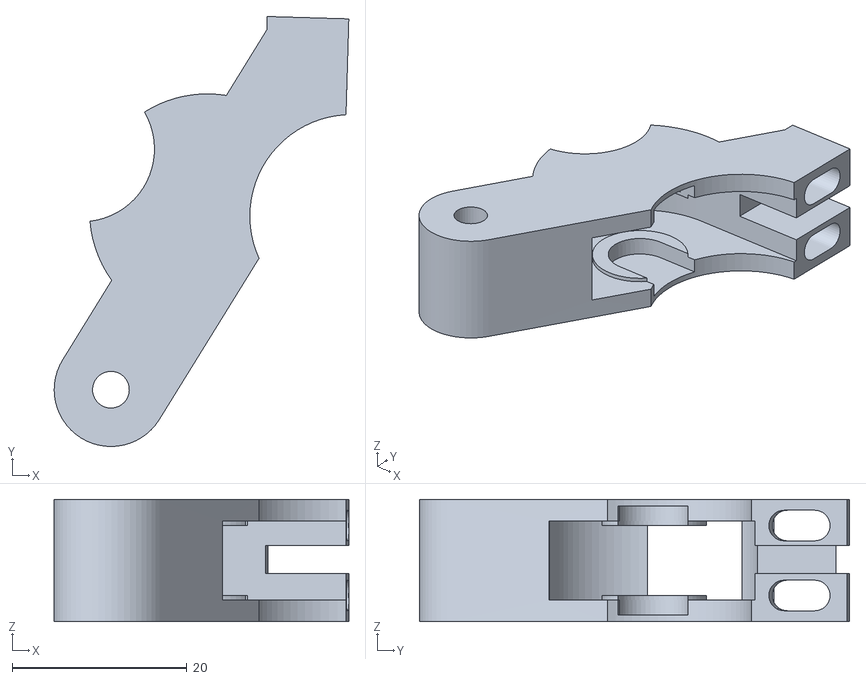
[picture p57: CAD file, 2015-06-19]
Jasons Mods/Extruder_Idler_for_Ekstruder_X_Carriage.stl
33.7 x 49.2 x 14.0
