rotorit/Adapto/RP_Parts/STLs/10mm/Small_Gear_11T_For_Ekstruder_X_Carriage_LM10UU.stl

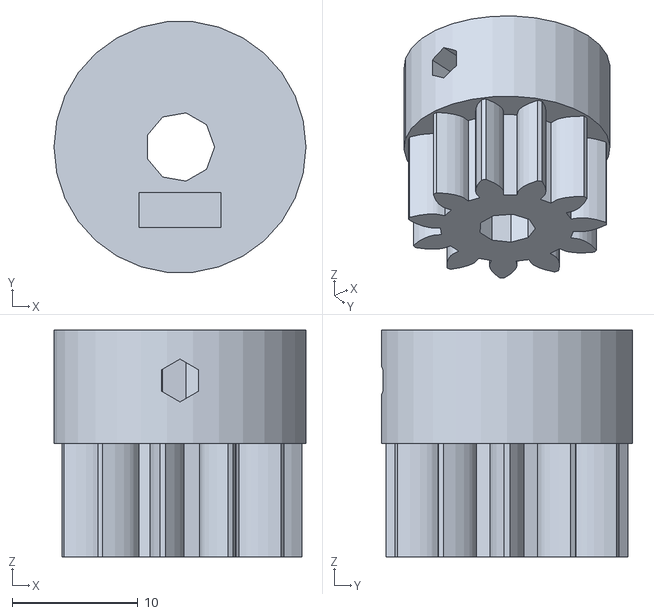
[picture p58: CAD file, 2013-09-12]
RP_Parts/STLs/10mm/Small_Gear_11T_For_Ekstruder_X_Carriage_LM10UU.stl
20.0 x 19.9 x 18.0
