rotorit/Adapto/Jasons Mods/Foot_Alternative_Short.stl

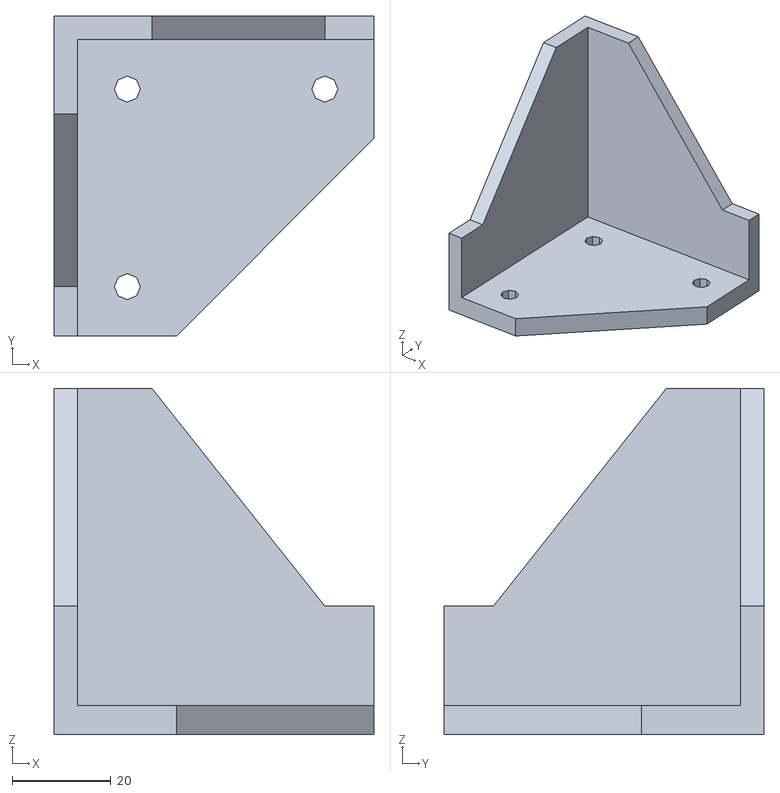
[picture p59: CAD file, 2015-06-09]
Jasons Mods/Foot_Alternative_Short.stl
64.7 x 64.8 x 70.1
