rotorit/Adapto/RP_Parts/STLs/10mm/Ekstruder_X_Carriage_LM10UU.STL

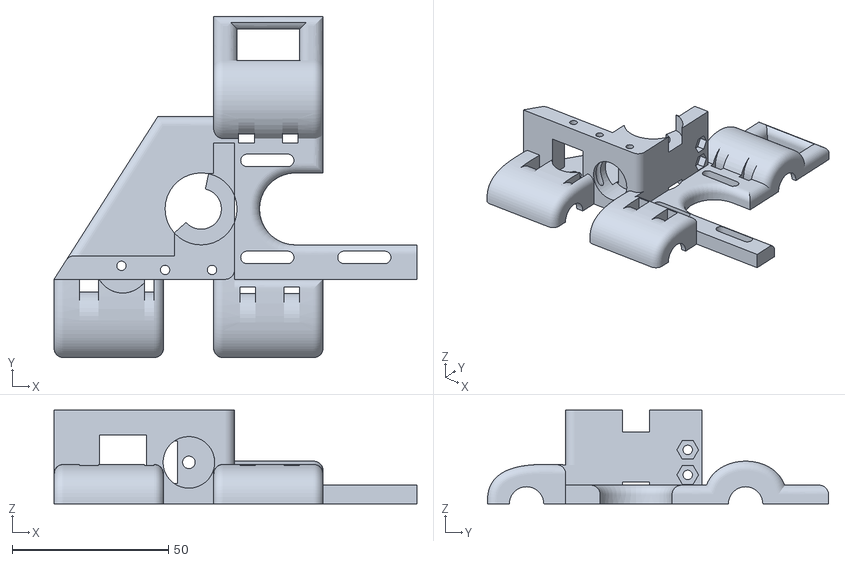
[picture p60: CAD file, 2013-09-12]
RP_Parts/STLs/10mm/Ekstruder_X_Carriage_LM10UU.STL
116.0 x 109.0 x 30.0
