rotorit/Adapto/RP_Parts/STLs/Large_Gear_T36_1_Off.stl

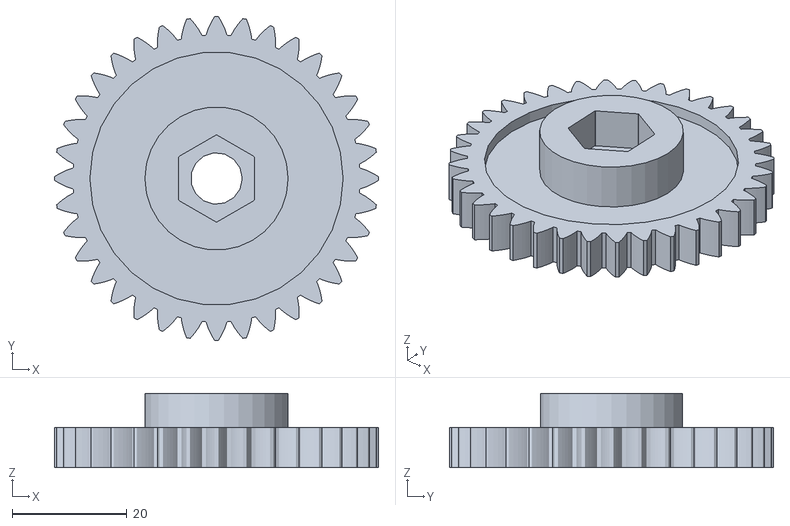
[picture p61: CAD file, 2013-01-01]
RP_Parts/STLs/Large_Gear_T36_1_Off.stl
56.6 x 56.6 x 13.0
