rotorit/Adapto/Jasons Mods/10mm_Opto_EndStop_Mount.stl

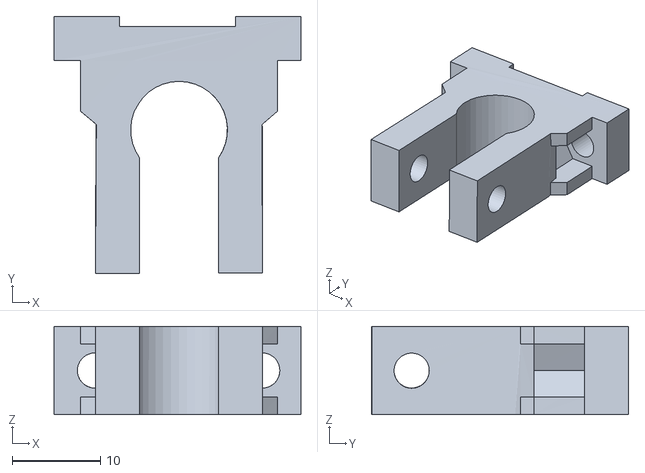
[picture p62: CAD file, 2015-06-09]
Jasons Mods/10mm_Opto_EndStop_Mount.stl
28.1 x 29.2 x 10.0
