rotorit/Adapto/RP_Parts/STLs/10mm/Y_Bearing_holder_LM10UU.STL

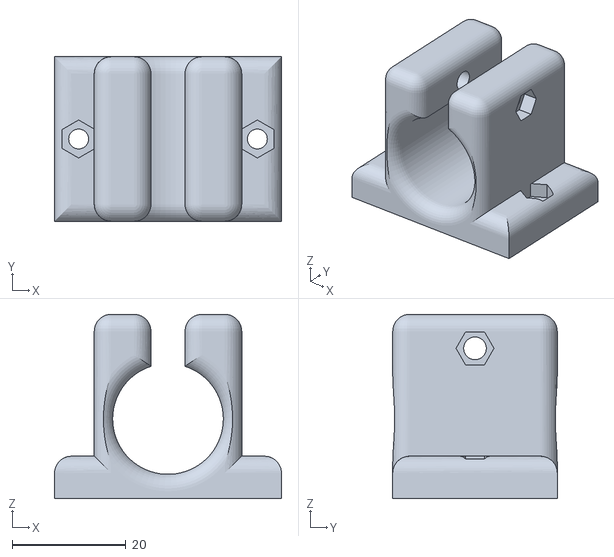
[picture p63: CAD file, 2013-09-12]
RP_Parts/STLs/10mm/Y_Bearing_holder_LM10UU.STL
40.0 x 29.0 x 32.5
