rotorit/Adapto/RP_Parts/STLs/90_innerCorner.stl

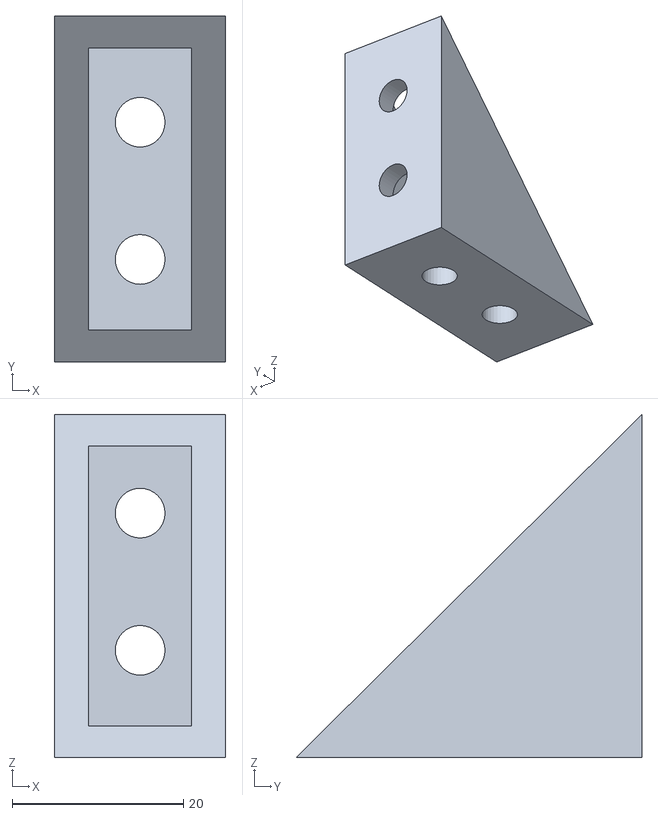
[picture p64: CAD file, 2013-01-01]
RP_Parts/STLs/90_innerCorner.stl
20.0 x 40.3 x 40.0
