rotorit/Adapto/Jasons Mods/10mm_X_Motor_End_Mount_1_Off.stl

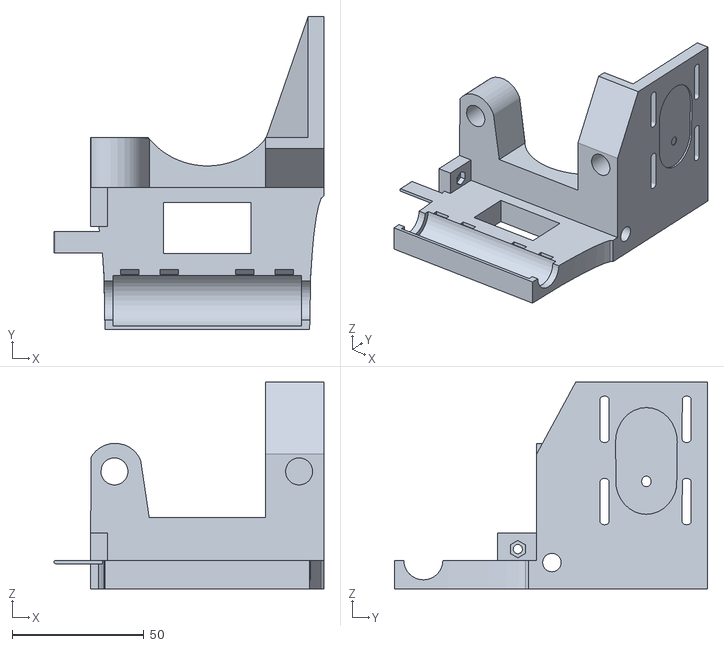
[picture p65: CAD file, 2015-06-09]
Jasons Mods/10mm_X_Motor_End_Mount_1_Off.stl
102.3 x 118.8 x 78.4
