rotorit/Adapto/RP_Parts/STLs/10mm/X_End_Motor_10mm_M5_1_Off.stl

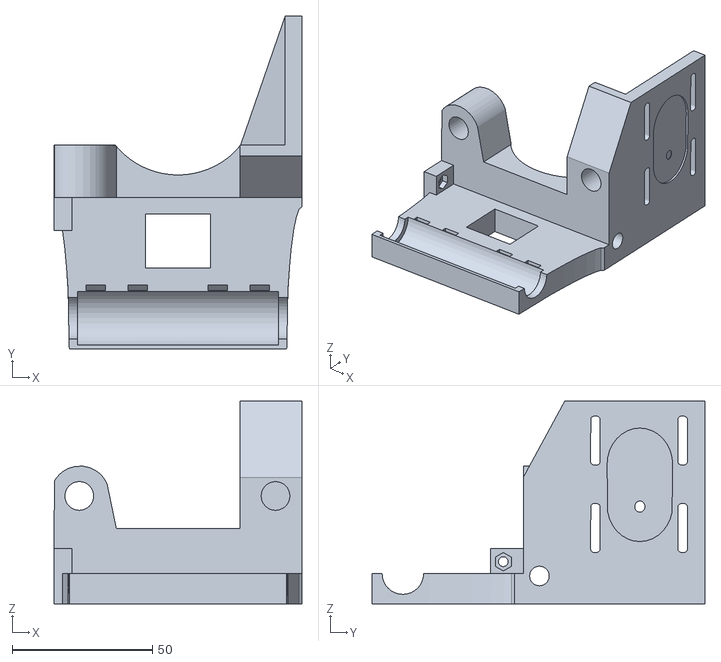
[picture p66: CAD file, 2013-08-26]
RP_Parts/STLs/10mm/X_End_Motor_10mm_M5_1_Off.stl
88.5 x 118.8 x 72.4
