rotorit/Adapto/RP_Parts/STLs/X_End_Idler_1_Off.stl

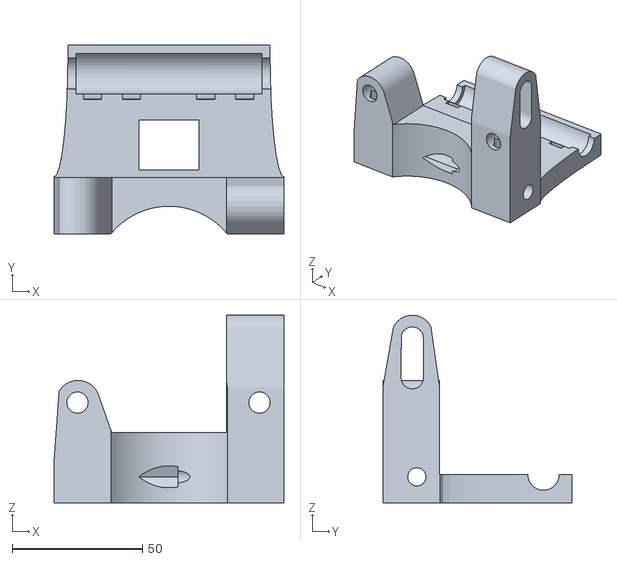
[picture p67: CAD file, 2013-01-01]
RP_Parts/STLs/X_End_Idler_1_Off.stl
88.5 x 72.8 x 72.1
