rotorit/Adapto/RP_Parts/STLs/Z_Couplers_M5.stl

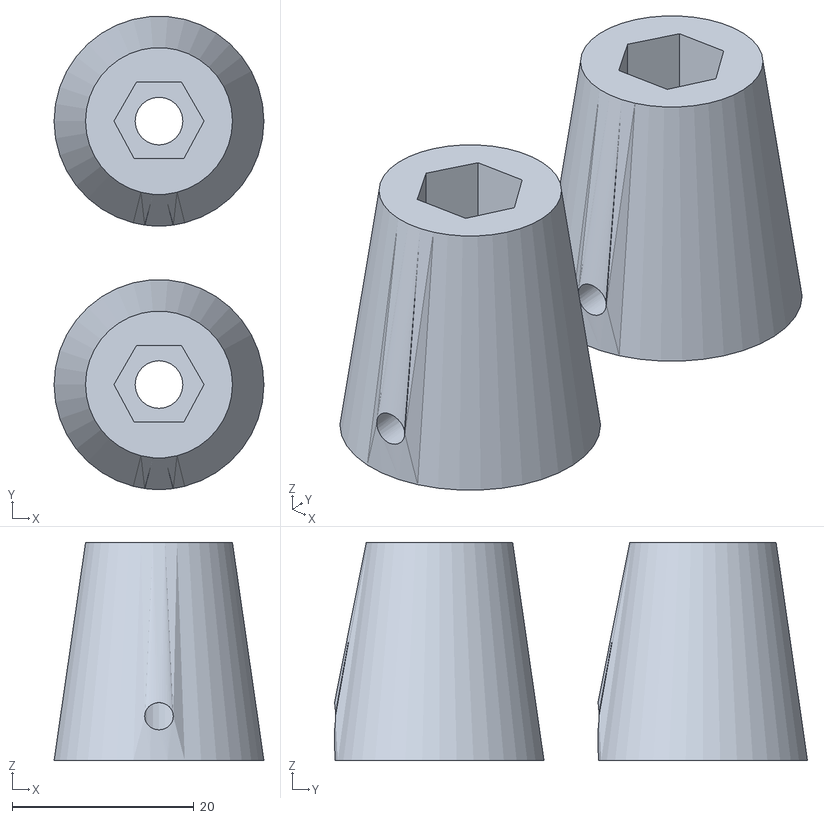
[picture p68: CAD file, 2012-12-28]
RP_Parts/STLs/Z_Couplers_M5.stl
23.1 x 52.1 x 24.0
