rotorit/Adapto/RP_Parts/STLs/10mm/10mm_X_Idler_1_Off.stl

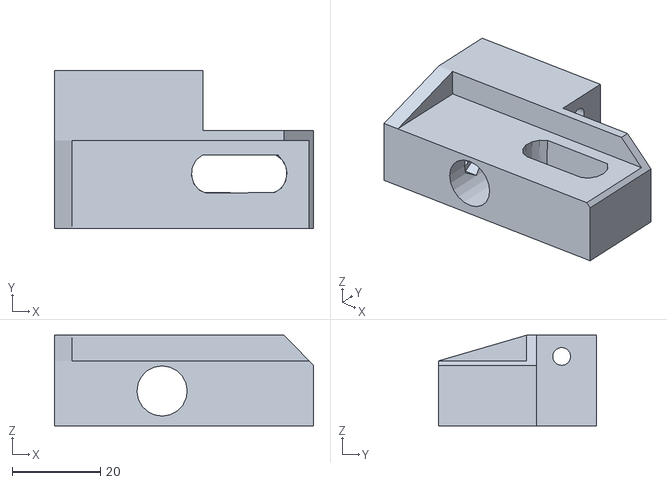
[picture p69: CAD file, 2012-09-17]
RP_Parts/STLs/10mm/10mm_X_Idler_1_Off.stl
58.8 x 35.9 x 20.6
