rotorit/Adapto/RP_Parts/STLs/X_Idler_1_Off.stl

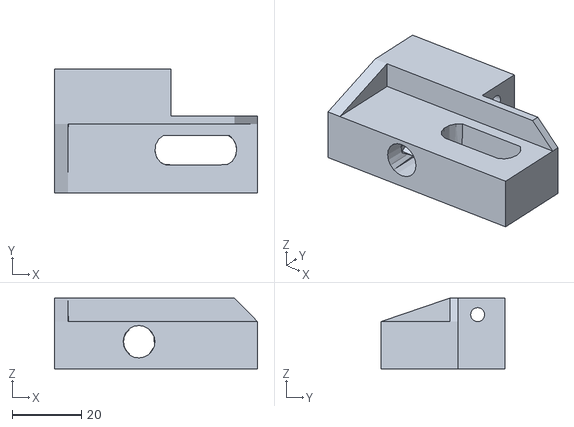
[picture p70: CAD file, 2012-09-17]
RP_Parts/STLs/X_Idler_1_Off.stl
58.8 x 35.8 x 20.6
