rotorit/Adapto/RP_Parts/STLs/10mm/10mm_Extruder_X_Carriage_Combo_1_Off.stl

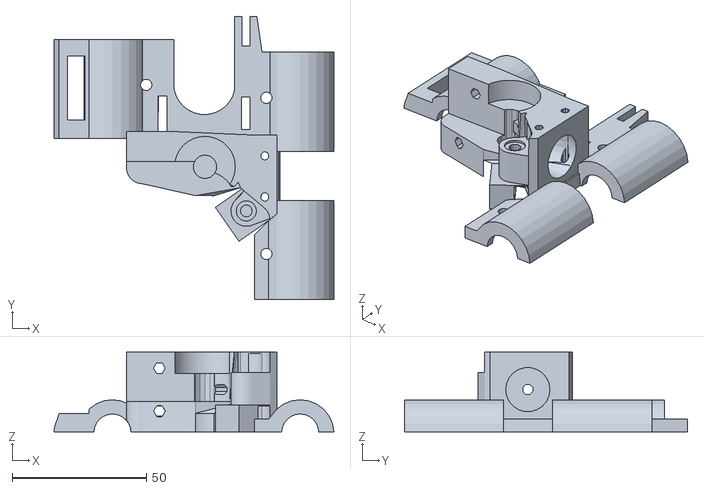
[picture p71: CAD file, 2012-09-17]
RP_Parts/STLs/10mm/10mm_Extruder_X_Carriage_Combo_1_Off.stl
104.3 x 105.5 x 29.8
