rotorit/Adapto/RP_Parts/STLs/X_Bar_Clamp_2_Off.stl

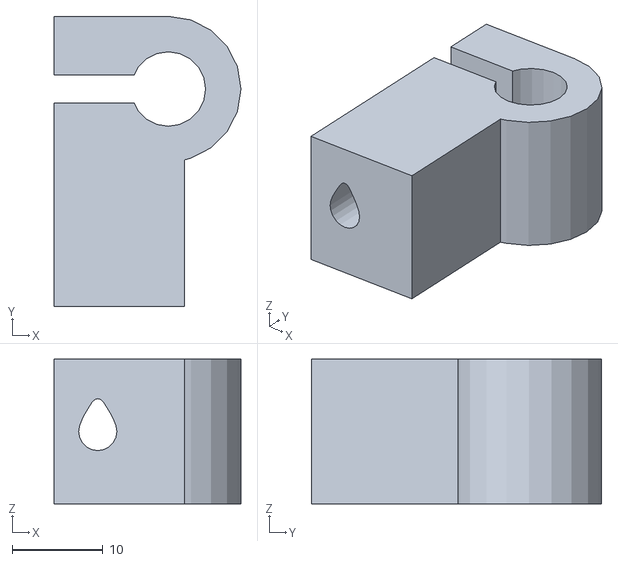
[picture p72: CAD file, 2012-08-26]
RP_Parts/STLs/X_Bar_Clamp_2_Off.stl
20.6 x 32.0 x 16.0
