rotorit/Adapto/RP_Parts/STLs/Foot_4_Off.stl

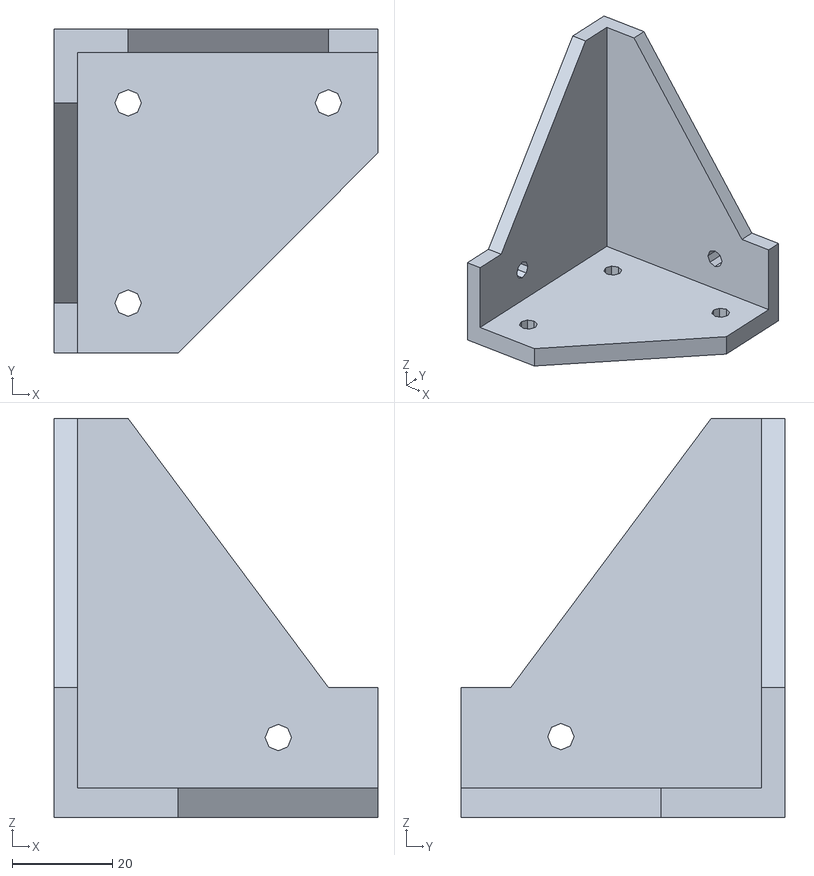
[picture p73: CAD file, 2012-08-26]
RP_Parts/STLs/Foot_4_Off.stl
64.7 x 64.8 x 79.7
