rotorit/Adapto/RP_Parts/STLs/10mm/10mm_X_End_Z_Bearing_C_Clamp_4_Off.stl

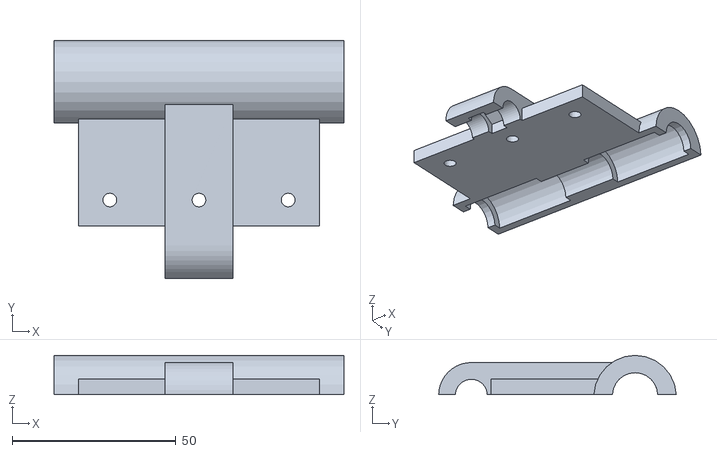
[picture p74: CAD file, 2012-09-11]
RP_Parts/STLs/10mm/10mm_X_End_Z_Bearing_C_Clamp_4_Off.stl
88.6 x 72.6 x 12.0
