rotorit/Adapto/RP_Parts/STLs/X_End_Z_Bearing_C_Clamp_4_Off.stl

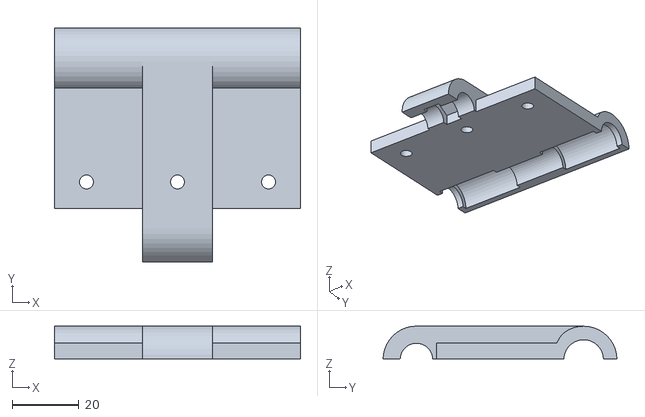
[picture p75: CAD file, 2012-08-26]
RP_Parts/STLs/X_End_Z_Bearing_C_Clamp_4_Off.stl
73.6 x 69.9 x 9.81
