rotorit/Adapto/RP_Parts/STLs/10mm/10mm_X Bar Clamp 2 Off.stl

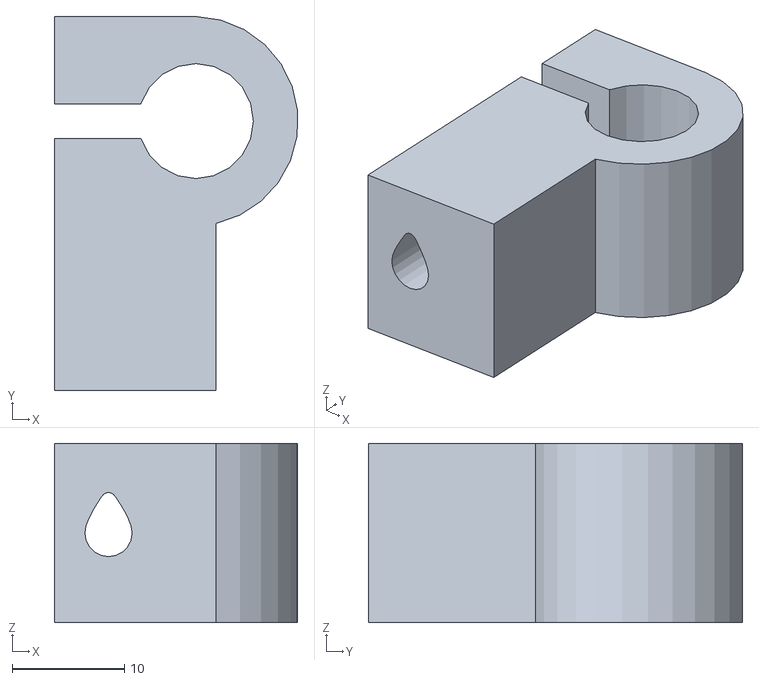
[picture p76: CAD file, 2012-09-10]
RP_Parts/STLs/10mm/10mm_X Bar Clamp 2 Off.stl
21.6 x 33.3 x 16.0
