rotorit/Adapto/RP_Parts/STLs/Y_Belt_Block_1_Off.stl

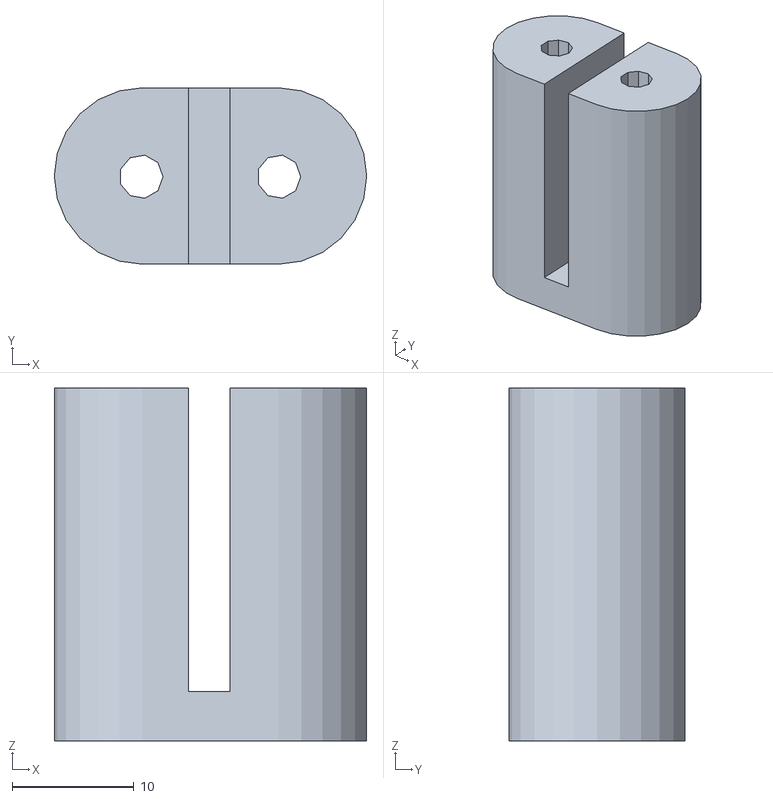
[picture p77: CAD file, 2012-08-26]
RP_Parts/STLs/Y_Belt_Block_1_Off.stl
25.7 x 14.5 x 29.0
