rotorit/Adapto/RP_Parts/STLs/10mm/10mm_Z_Smooth_Rod_Holder_Upper_2_Off.stl

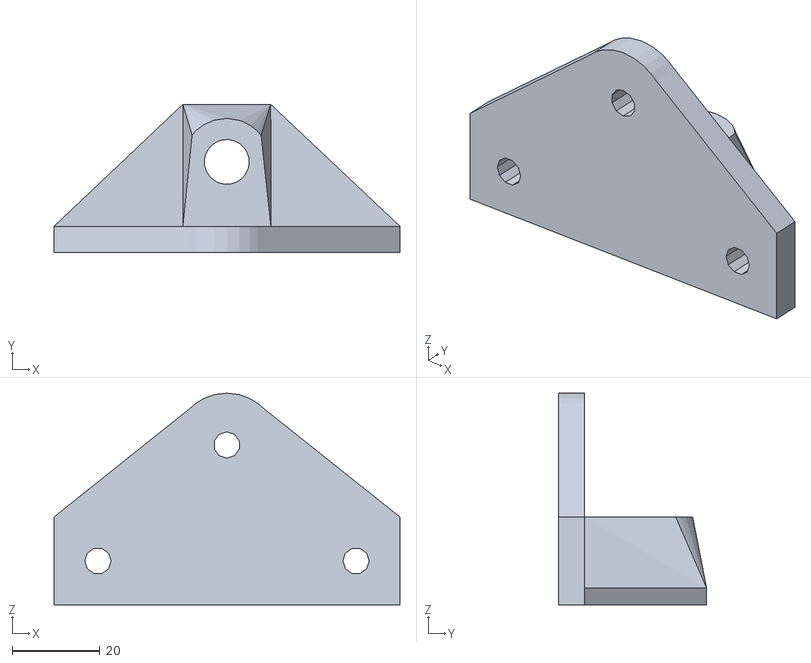
[picture p78: CAD file, 2012-09-08]
RP_Parts/STLs/10mm/10mm_Z_Smooth_Rod_Holder_Upper_2_Off.stl
78.7 x 33.8 x 48.2
