rotorit/Adapto/RP_Parts/STLs/X_Motor_Mount_1_Off.stl

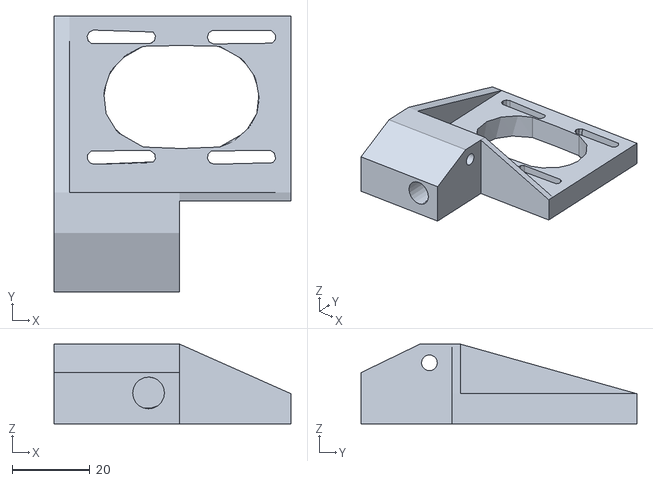
[picture p79: CAD file, 2012-08-26]
RP_Parts/STLs/X_Motor_Mount_1_Off.stl
61.1 x 71.1 x 20.6
