rotorit/Adapto/RP_Parts/STLs/10mm/10mm_Z_Smooth_Rod_Holder_Lower_2_Off.stl

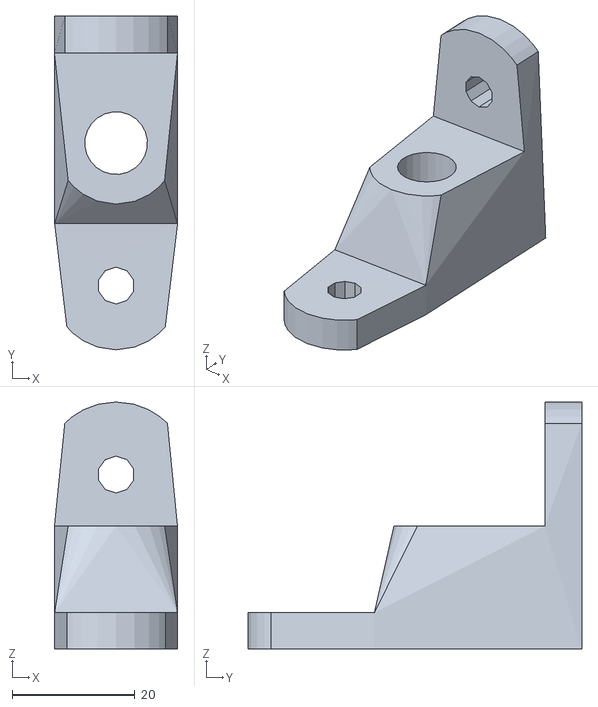
[picture p80: CAD file, 2012-09-08]
RP_Parts/STLs/10mm/10mm_Z_Smooth_Rod_Holder_Lower_2_Off.stl
20.0 x 54.3 x 40.2
