rotorit/Adapto/RP_Parts/STLs/Z_Motor_Holder_2_Off.stl

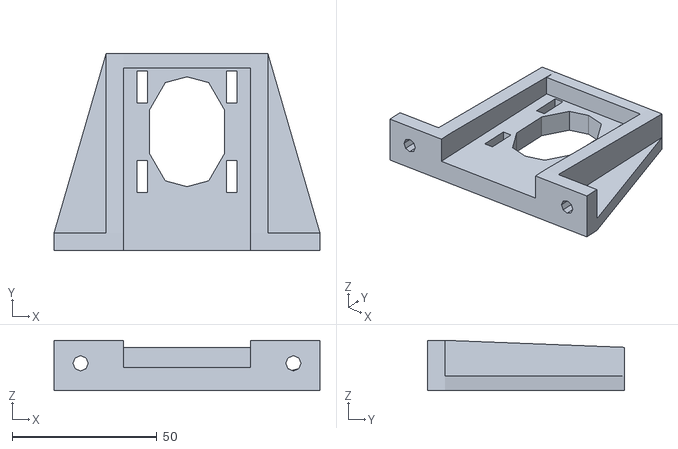
[picture p81: CAD file, 2012-08-26]
RP_Parts/STLs/Z_Motor_Holder_2_Off.stl
92.0 x 68.0 x 17.4
