rotorit/Adapto/RP_Parts/STLs/Small_Gear_T13_1_Off.stl

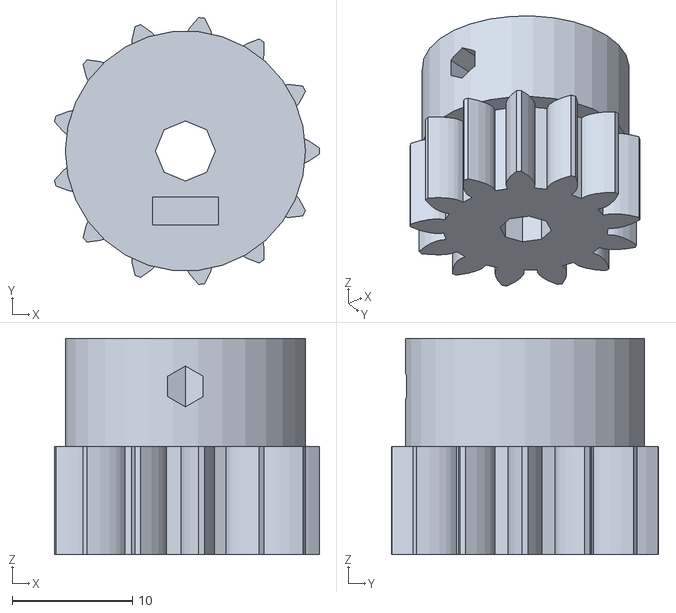
[picture p82: CAD file, 2012-08-26]
RP_Parts/STLs/Small_Gear_T13_1_Off.stl
22.1 x 22.2 x 18.0
