rotorit/Adapto/(list of files, cad)

Other CAD files:
Adapto_V_3.0_/10mm/Extruder_X_Carriage_Combo_LM10UU.SLDPRT
Adapto_V_3.0_/SourceFiles/SoldWorks .sldprt/Y_Rod_Clamp_10mm_4_Off.SLDPRT
RP_Parts/STLs/10mm/Extruder_Idler_For_Ekstruder_X_Carriage_LM10UU.STL
Adapto_V_3.0_/10mm/Y_Rod_Clamp_10mm_4_Off.STL
Adapto_V_3.0_/SourceFiles/SoldWorks .sldprt/Y_Rod_Clamp_8mm_4_Off.SLDPRT
Jasons Mods/10mm_Z_Smooth_Rod_Holder_Upper_Right.stl
RP_Parts/STLs/Z_Smooth_Rod_Holder_Upper_2_Off.stl
RP_Parts/STLs/Y_Motor_Mount_1_Off.stl
RP_Parts/STLs/10mm/X_End_Idler_10mm_M5_1_Off.stl
RP_Parts/STLs/10mm/10mm_X_Motor_Mount_1_Off.stl
Adapto_V_3.0_/M6 optional/X_End_Idler_LM8UU_M6_Z_Screws.stl
Adapto_V_3.0_/M6 optional/X_End_Motor_LM8UU_M6_Z_Screws.stl
Jasons Mods/8mm Leadscrew Parts/10mm_Z_Axis_Top_Motor_Mounts.stl
Jasons Mods/8mm Leadscrew Parts/8mm_Leadscrew_Guides_Bottom_End.stl
Jasons Mods/8mm Leadscrew Parts/8mm_Leadscrew_Guides_Top_End.stl
Jasons Mods/8mm Leadscrew Parts/8mm_Leadscrew_X_Axis_Idle_End.stl
Jasons Mods/8mm Leadscrew Parts/8mm_Leadscrew_X_Axis_Motor_End.stl
Old/RP_Parts/SCADs/Example_STLs/baseFoot_x4.stl
Old/RP_Parts/SCADs/Example_STLs/baseFoot_x4_Alternate.stl
Old/RP_Parts/SCADs/Example_STLs/cornerBrace_x8.stl
Old/RP_Parts/SCADs/Example_STLs/cornerBrace_x8_Alternate.stl
Old/RP_Parts/SCADs/Example_STLs/holeCalibration.stl
Old/RP_Parts/SCADs/Example_STLs/xIdler_x1.stl
Old/RP_Parts/SCADs/Example_STLs/xMotor_x1.stl
Old/RP_Parts/SCADs/Example_STLs/yBearing_x3.stl
Old/RP_Parts/SCADs/Example_STLs/yBlock_x1.stl
Old/RP_Parts/SCADs/Example_STLs/yBlock_x1_Alternate.stl
Old/RP_Parts/SCADs/Example_STLs/yClamp_x4.stl
Old/RP_Parts/SCADs/Example_STLs/yClamp_x4_Alternate.stl
Old/RP_Parts/SCADs/Example_STLs/yIdler_x1.stl
Old/RP_Parts/SCADs/Example_STLs/yIdler_x1_Alternate.stl
Old/RP_Parts/SCADs/Example_STLs/yMotor_x1.stl
Old/RP_Parts/SCADs/Example_STLs/zCoupler_x2.stl
Old/RP_Parts/SCADs/Example_STLs/zLower_x2.stl
Old/RP_Parts/SCADs/Example_STLs/zMotor_x2.stl
Old/RP_Parts/SCADs/Example_STLs/zMotor_x2_Alternate.stl
Old/RP_Parts/SCADs/Example_STLs/zUpper_x2.stl
Old/RP_Parts/SCADs/baseFoot_x4.scad
Old/RP_Parts/SCADs/cornerBrace_x8.scad
Old/RP_Parts/SCADs/holeCalibration.scad
Old/RP_Parts/SCADs/inc/configuration.scad
Old/RP_Parts/SCADs/inc/nemaMount.scad
Old/RP_Parts/SCADs/inc/polyarc.scad
Old/RP_Parts/SCADs/inc/xBacker.scad
Old/RP_Parts/SCADs/original/parametric_involute_gear_v5.0.scad
Old/RP_Parts/SCADs/xIdler_x1.scad
Old/RP_Parts/SCADs/xMotor_x1.scad
Old/RP_Parts/SCADs/yBearing_x3.scad
Old/RP_Parts/SCADs/yBlock_x1.scad
Old/RP_Parts/SCADs/yClamp_x4.scad
Old/RP_Parts/SCADs/yIdler_x1.scad
Old/RP_Parts/SCADs/yMotor_x1.scad
Old/RP_Parts/SCADs/zCoupler_x2.scad
Old/RP_Parts/SCADs/zLower_x2.scad
Old/RP_Parts/SCADs/zMotor_x2.scad
Old/RP_Parts/SCADs/zUpper_x2.scad
Old/RP_Parts/STLs/10mm/10mmOLD/10mm_X_Motor_Mount_1_Off.stl
Old/RP_Parts/STLs/10mm/10mmOLD/X_End_Idler_10mm_M5_1_Off.stl
Old/RP_Parts/STLs/10mm/Extruder_Idler_For_Ekstruder_X_Carriage_LM10UU.STL
Old/RP_Parts/STLs/10mm/Extruder_X_Carriage_Combo_LM10UU.STL
Old/RP_Parts/STLs/8mm/Y_Rod_Clamp_8mm_4_Off.stl
Old/RP_Parts/STLs/8mm/Z_Smooth_Rod_Holder_Upper_8mm_2_Off.stl
Old/RP_Parts/STLs/ADAPTO.blend
Old/RP_Parts/STLs/M6/X_End_Idler_LM8UU_M6_Z_Screws.stl
Old/RP_Parts/STLs/M6/X_End_Motor_LM8UU_M6_Z_Screws.stl
Old/RP_Parts/STLs/Y_Motor_Mount_1_Off.stl
Old/RP_Parts/SolidWorks/Source/Extruder_X_Carriage_Combo_LM10UU.SLDPRT
RP_Parts/SCADs/parametric_involute_gear_v5.0.scad
RP_Parts/STLs/ADAPTO.blend
RP_Parts/STLs/Y_Rod_Clamp_4_Off.stl
