rotorit/Adapto/(threads)

Thread 8 (2015-05-31):

8mm Extruder body zip tie holes

bbriggstkd, 2015-05-31:
The 8mm extruder body does not have the zip tie holes for the top bearing.  The 10mm file does have them.  Are there plans to add them?

rotorit, 2015-05-31:
Ah.. sorry... I totally forgot about that.
Thanks for reminding me.
Will do this asap.
If you altreadu printed the part it is no problem to drill these holes manually.
and.. it is allso possible to use the 10mm version for 8mm bearings....

rotorit, 2015-05-31:
Now i have added the missing ziptie holes

Closed 2015-05-31.

Thread 12 (2015-06-21):

Extruder Carriage width potential issue

bbriggstkd, 2015-06-21:
I want to start off my saying that this may just be with my equipment.  I have an echertek hobbed bolt. The width of the extruder body between the bearings that hold the hobbed bolt is too wide, I think.  I compared what was in the design for the original Adapto with the new version it looks like it's about 4 mm wider, which makes the teeth not line up correctly.

jasonhurd, 2015-06-21:
Hello

That is correct, the E3D version is a wider between the bearings in order for the E3D-V6 heat sink fins to clear the smooth rod. I had taken this approach as other methods would have complicated the print or allowed for less material to hold in the LM10UU bearings.

I have used a garden variety hobbed bolt (purchased off ebay) that seems to be long enough to do the job. Could you please provide reference to the specs on the echertek hobbed bolt that you are using as I can not seem to find any information on it. Also If you could provide a picture of your assembly, I would appreciate it.

Attached is the specs of the hobbed bolt that I have used. I will also provide an image of my assembly soon.

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

bbriggstkd, 2015-06-21:
I'm referring to the M8 version.  I can't find any reference to a E3D version so I don't know.  This is the path to the file.  \Adapto-master v3\Adapto-master\Old\RP_Parts\STLs\8mm\Extruder_X_Carriage_Combo_LM8UU_1_off.STL.  I can't find diagram of the echertech bolt.  Here is a link to the web site.  http://www.eckertech.com/reprap-hobbed-bolt-kit-for-wades-extruder/

I use a J Head hot end but that shouldn't matter if I can get the bolt to work.
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

jasonhurd, 2015-06-22:
It appears to me that the echertech hobbed bolt length and positioning of the hobbed section is tailored to the Wade's Extruder. It may be easier to obtain a new (longer) hobbed bolt if you are looking to build yourself an Adapto.

Others may have a different viewpoint. :-)

Jason

bbriggstkd, 2015-06-22:
I was thinking about that.  Most of the newer versions I've seen reviews on are hard to find.  I found the web site for the one you showed me but it's under construction.  I'll have to look at the specs for ones on eBay.  I'll just keep using the Adapto v1 carriage for now.

rotorit, 2015-09-10:
It is recommended to make the hobbed bolt yourself and that way you can make sure it fits the extruder.:-)

Closed 2015-09-10.

Thread 14 (2015-11-23):

X end motor mount scad doesn't create the same part shown for Adapto.

fototheory, 2015-11-23:
X_Motor_Mount_1_Off.scad doesn't render the actual part. Here is what I get:

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

GearheadRed, 2015-12-15:
I submitted a pull request to fix this.

fototheory, 2015-12-16:
Cool. Thanks.

rotorit, 2015-12-29:
Pull request merged so.. i guess this is solved :-)

Closed 2015-12-29.

Thread 17 (2020-06-07):

Please add Solid Part Files

Bloodpilot, 2020-06-07:
I know the Project is not the newest, but I still got my Adapto and I plan to reengineer it. For that reason, it would be nice to have the Solid Part Files (or whatever you have).

GearheadRed, 2020-06-07:
Most all the parts are designed using OpenSCAD( https://www.openscad.org/ )
. The scripts in the various folders can all be opened in OpenSCAD to
generate the solid models or view changes to the design after tweaking the
code. An STL file can be generated from that software to 3D print the part.
There is a bit of a learning curve to it but it can be fun to use if you
are somewhat programming oriented.

They were not designed using a typical CAD package like SolidWorks or
AutoCAD to make any of those files available. I think at one point I think
there was hope to find a volunteer to re-design the files in one of those
softwares but the licensing for the software made it difficult to find many
people with time, software, and interest to do it.

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
