rotorit/Adapto/(commit log)

2012-08-26 Creating folders and uploading STL file
    [Foot_4_Off.stl]
2012-08-26 Added some files
    [90_Corner_Inner_4_Off.stl, Extruder_Idler_1_Off.stl, Extruder_X_Carriage_Combo_1_Off.stl, Foot_4_Off.stl, Foot_X_4.stl, Large_Gear_T36_1_Off.stl, Small_Gear_T13_1_Off.stl, X_Bar_Clamp_2_Off.stl]
2012-09-07 made some holes round
    [X_Idler_1_Off.stl]
2012-09-07 Created new files
    [90_corner_inner_4_off.scad, bolt.scad, configuration.scad, foot_4_off.scad]
2012-09-07 New X_bar_clamp_2_off.scad
    [X_bar_clamp_2_off.scad, configuration.scad]
2012-09-08 Coincident surface fix
    [X_bar_clamp_2_off.scad]
2012-09-08 Some Edited STL's for 10mm
    Untested
    [10mm_Y_Rod_Clamp_4_Off.stl, 10mm_Z_Smooth_Rod_Holder_Lower_2_Off.stl, 10mm_Z_Smooth_Rod_Holder_Upper_2_Off.stl]
2012-09-10 More 10mm Changes
    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
    [10mm_X Bar Clamp 2 Off.stl, 10mm_X_End_Z_Bearing_C_Clamp_4_Off.stl]
2012-09-11 Fixed Lm10uu Length
    Fixed Lm10uu Length
    [10mm_X_End_Z_Bearing_C_Clamp_4_Off.stl]
2012-09-13 More 10mm Changes
    10mm Changes
    [10mm_Extruder_X_Carriage_Combo_1_Off.stl, 10mm_X_Motor_Mount_1_Off.stl]
2012-09-13 More 10mm Changes
    More 10mm Changes
    [10mm_X_Idler_1_Off.stl, 10mm_Y_Rod_Clamp_4_Off.stl]
2012-09-13 Added Recess to fit M3 10mm for Securing Bar
    Added Recess to fit M3 10mm for Securing Bar
    [10mm_X_Idler_1_Off.stl, X_Idler_1_Off.stl]
2012-09-14 Uploaded the correct Y motor mount
    [Y_Motor_Mount_1_Off.stl]
2012-09-14 Added new folder and new y motor mount
    [Y_Motor_Mount_1_Off.stl, Y_Motor_Mount_1_Off_For_20mm_Thick_Extrisions_or_plates_only.stl]
2012-09-16 Fixed direction of stl
    [10mm_X_Motor_Mount_1_Off.stl]
2012-09-17 new file: X_idler_1_off.scad
    [X_idler_1_off.scad]
2012-09-17 Added smooth rod set screw hole and countersink
    [X_idler_1_off.scad]
2012-09-20 Minor changes to the Extruder
    [Extruder_X_Carriage_Combo_1_Off.stl]
2012-09-20 new stl file
    [Extruder_X_Carriage_Combo_1_Off.stl]
2012-09-20 minor change to STL file
    [Extruder_X_Carriage_Combo_1_Off.stl]
2012-09-26 Editet Folder name and then some
    Editet Folder name and added new Y-motor mount and Y-idler
    [Y_Idler_1_Off.stl, Y_Motor_Mount_1_Off.stl, Y_Motor_Mount_1_Off_For_20mm_Thick_Extrisions_or_plates_only.stl]
2012-09-26 new y motor mount. AGAIN :-)
    [Y_Motor_Mount_1_Off.stl]
2012-11-11 Created x motor mount
    [X_Motor_Mount_1_Off.scad]
2012-11-11 Removed some plastic that might crash with the extruder
    [X_Motor_Mount_1_Off.scad]
2012-11-13 added Y_Belt_Block_1_Off.scad changes in config taken from Prusa 2 metric stuff with attribution
    [Y_Belt_Block_1_Off.scad, configuration.scad]
2012-12-01 Added Z_Smooth_Rod_Holder_Upper_2_Off.scad
    [Z_Smooth_Rod_Holder_Upper_2_Off.scad, configuration.scad]
2012-12-01 Added Z_Smooth_Rod_Holder_Lower_2_Off.scad
    [Z_Smooth_Rod_Holder_Lower_2_Off.scad]
2012-12-05 deleted a file
    [90_corner_inner_4_off.scad]
2012-12-06 Added Y_Bearing_Holder_LM8UU_3_Off.scad
    [Y_Bearing_Holder_LM8UU_3_Off.scad]
2012-12-09 edited file names
    [90_Corner_Inner_6_Off.stl]
2012-12-09 edited file name
    [90_corner_inner_6_off.scad]
2012-12-18 edited folder name
    [Y_Idler_1_Off.stl, Y_Motor_Mount_1_Off.stl, Y_Motor_Mount_1_Off_For_20mm_Thick_Extrisions_or_plates_only.stl]
2012-12-27 added Dev dir and some untested parts
    [X_End_Idler_1_Off.stl, X_End_Motor_1_Off.stl, X_Ends.blend]
2012-12-28 some updates to the new x ends
    [X_End_Idler_1_Off.stl, X_End_Motor_1_Off.stl, X_Ends.blend, Z_Couplers_M5.stl]
2012-12-28 file shuffle!
    [E-small_gear_and_M5_z_couplers.stl, Y_Motor_Mount_1_Off.stl]
2012-12-31 new x endsand.. then some
    [90_Corner_Inner_6_Off.stl, 90_innerCorner_new.stl, X_Bar_Clamp_2_Off.stl, X_End_Idler_1_Off.stl, X_End_Motor_1_Off.stl, X_End_Z_Bearing_C_Clamp_4_Off.stl, X_Ends.blend, X_Idler_1_Off.stl]
2013-01-01 some updates on x ends and 90 inner corner parts
    [90_innerCorner.stl, 90_innerCorner_new.stl, 90_inner_corner_x_4.stl, X_End_Idler_1_Off.stl, X_End_Motor_1_Off.stl, X_Ends.blend, X_Ends.stl]
2013-01-01 small change on the large gear
    [Large_Gear_T36_1_Off.stl]
2013-01-12 New Y Motor Mount
    [Y_Motor_Mount_1_Off.stl]
2013-01-13 (o)(o) :D som file shupple and parts flaw repairs
    [Extruder_X_Carriage_Combo_1_Off.stl, Y_Bearing_Holder_LM8UU_3_Off.stl, Y_Idler_1_Off.stl, Y_Motor_Mount_1_Off_For_20mm_Thick_Extrusions_or_plates_only.stl, Z_Couplers_M8_2_Off.stl, Z_Smooth_Rod_Holder_Lower_2_Off.stl, Z_Smooth_Rod_Holder_Upper_2_Off.stl]
2013-01-13 closed a hole in the mesh
    [Z_Smooth_Rod_Holder_Upper_2_Off.stl]
2013-01-13 WOW.. massive update
    [90_inner_corner_x_4.stl, E-small_gear_and_M5_z_couplers.stl, Foot_X_4.stl, X_Bar_Clamp_2_Off.stl, X_End_Idler_1_Off.stl, X_End_Motor_1_Off.stl, X_End_Z_Bearing_C_Clamp_4_Off.stl, X_Ends.blend]
2013-01-13 added some endstops
    [Endstop_Holders_X_3.stl]
2013-01-13 new z tod holder upper. minor adjustments
    [Z_Smooth_Rod_Holder_Upper_2_Off.stl]
2013-01-13 z rod holder upper
    layed flat on surface and centered the x rod holder upper
    [Z_Smooth_Rod_Holder_Upper_2_Off.stl]
2013-01-13 Blender file added
    A blender (.blen) with all the STL files mounted as they should.
    [ADAPTO.blend]
2013-04-14 Corrected dimensions for non 20x20 extrusions
    [Z_Smooth_Rod_Holder_Lower_2_Off.scad, Z_Smooth_Rod_Holder_Upper_2_Off.scad]
2013-04-14 Added Y_Rod_Clamp_4_Off.scad
    [Y_Rod_Clamp_4_Off.scad]
2013-04-14 Single clamp, not 4
    [Y_Rod_Clamp_4_Off.scad]
2013-04-15 Added new, simple Z_Motor_Holder_2_Off.scad
    [Z_Motor_Holder_2_Off.scad]
2013-04-16 turned it into a module for easier (re-)use
    [foot_4_off.scad]
2013-04-18 Added Y_Idler_1_Off.scad
    [Y_Idler_1_Off.scad]
2013-04-19 Added fan_holder_large_optional_extra.scad
    [fan_holder_large_optional_extra.scad]
2013-04-22 Added foot2(), a smaller version designed to save plastic and fit under the frame
    [foot_4_off.scad]
2013-05-09 Update based on RoTorITs version spring 2013
    [X_idler_1_off.scad, configuration.scad]
2013-05-10 Added hole_calibration.scad to calibrate M3, M5 and M8 holes and nut traps
    [configuration.scad, hole_calibration.scad]
2013-05-11 frame should be 20x20 by default
    [configuration.scad]
2013-06-07 Added minimal Z motor holder designed to fit with the small feet
    [Z_Motor_Holder_2_Off.scad, foot_4_off.scad]
2013-06-07 Added Y idler with belt tensioner
    [Y_Idler_1_Off.scad]
2013-06-16 DXFs in progress
    [Adapto_6_To_20mm_DXF.blend, Adapto_All.dxf]
2013-06-16 Optional small foot STL added
    [OPTIONAL_small_foot_4_off.stl]
2013-06-16 Added explanation to foot_4_off.scad
    [foot_4_off.scad]
2013-07-14 new file: Z_Coupler.scad
    [Z_Coupler.scad, configuration.scad]
2013-07-14 deleted some files
    [Adapto_6_To_20mm_DXF.blend, Adapto_All.dxf, X_End_Idler_M6_Z_Screws.stl, X_End_Motor_M6_Z_Screws.stl, Y_Rod_Clamp_4_Off.SLDPRT, Y_Rod_Clamp_4_Off.STL, Z_Couplers_For_M6_and_M5_Nuts.stl]
2013-07-16 added new 10mm M5 X-ends
    [10mm_X Bar Clamp 2 Off.stl, 10mm_X_End_Z_Bearing_C_Clamp_4_Off.stl, 10mm_X_Idler_1_Off.stl, 10mm_X_Motor_Mount_1_Off.stl, X_End_Idler_10mm_M5_1_Off.stl, X_End_Motor_10mm_M5_1_Off.stl]
2013-08-26 Edited the x_motor_mounts
    Minor changes to the X motor mounts so it is possible to align the belt
    paralell to the x smooth rods
    [X_End_Motor_10mm_M5_1_Off.stl, X_End_Motor_1_Off.stl, X_End_Motor_M6_Z_Screws.stl]
2013-09-12 New 10mm files
    [10mm_Extruder_X_Carriage_Combo_1_Off.stl, Ekstruder_X_Carriage_LM10UU.STL, EndStop_Holder_For_10mm_SmoothReods.STL, Extruder_Idler_For_Ekstruder_X_Carriage_LM10UU.STL, Gears_33_11.stl, Large_Gear_33T_For_Ekstruder_X_Carriage_LM10UU.stl, Small_Gear_11T_For_Ekstruder_X_Carriage_LM10UU.stl, X_End_Idler_10mm_M5_1_Off.stl]
2014-05-16 Added new Y bearing holders for LM8UUs
    [ADAPTO.stl, Y_Bearing_Holder_LM8UU_3_Off.stl]
2014-06-02 new files
    Added new y smooth rod clamp that is a bit wider to better fit 10mm
    rods. added a easier to print extruder idler that have to be glued
    together after printing. ++
    [10mm_Y_Rod_Clamp_4_Off.stl, Extruder_Idler_For_Ekstruder_X_Carriage_LM10UU_splitted_for_easier_printing.STL, foot_4_off.stl]
2014-09-11 some small changes on extruder and its idler
    [Extruder_Idler_1_Off.stl, Extruder_Idler_For_Ekstruder_X_Carriage_LM10UU_splitted_for_easier_printing.STL, Extruder_Idler_splitted_for_easier_printing_optional_1_off.STL, Extruder_X_Carriage_Combo_1_Off.stl, Extruder_X_Carriage_Combo_LM10UU.STL, Extruder_X_Carriage_Combo_LM8UU_1_off.STL]
2014-10-25 RedesigningAdapto
    Doing a total evaluation and improvement of the Adapto 3D printer design
    First new files Y-rod clamps both 8mm and 10mm
    [10mm_Extruder_X_Carriage_Combo_1_Off.stl, 10mm_X Bar Clamp 2 Off.stl, 10mm_X_End_Z_Bearing_C_Clamp_4_Off.stl, 10mm_X_Idler_1_Off.stl, 10mm_X_Motor_Mount_1_Off.stl, 10mm_Y_Rod_Clamp_4_Off.stl, 10mm_Z_Smooth_Rod_Holder_Lower_2_Off.stl, 10mm_Z_Smooth_Rod_Holder_Upper_2_Off.stl]
2015-05-31 added missing ziptie holes on 8mm extruder
    added the missing ziptieholes on the x-carriage/extruder for LM8UU
    bearings
2015-06-09 Jason's Mods Include:
    1.) 10mm Opto End-Stop Holder
    a. This accommodates the standard opto endstops found on eBay etc.
    b. Mounted directly next to the smooth rod to pick up tabs included in modded X_motor_end_Mount and X_carraige
    2.) 10mm X Motor End Mount
    a. Widened the square hole in the middle to reduce print time and material usage.
    b. Added tab to bottom in order to pick up an opto endstop from the mount above.
    c. This tab will not be needed if using the Prox_Sensor_Mount
    3.) Ekstruder X Carriage LM10UU E3D-V6 Universal
    a. As the name suggests the biggest mod to this is the adapting to suit the E3D-V6 1.75mm Universal Extruder.
    b. Also features tool-le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
    [10mm_Opto_EndStop_Mount.stl, 10mm_X_Motor_End_Mount_1_Off.stl, Ekstruder_X_Carriage_LM10UU_E3D-V6-Universal.stl, Extruder_Hotend_Mount_for_E3D_X_Carriage.stl, Extruder_Idler_for_Ekstruder_X_Carriage.stl, Foot_Alternative_Short.stl, Prox_Sensor_Mount.stl]
2015-06-15 Added Y-Axis belt holder (modified from http://www.thingiverse.com/thing:874757). Added 10mm Z-Axis smooth rod holder UPPER RIGHT. This now has a hole to secure the Z threaded rod for easier travel. 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
    [10mm_Z_Smooth_Rod_Holder_Upper_Left.stl, 10mm_Z_Smooth_Rod_Holder_Upper_Right.stl, Extruder_Hotend_Mount_for_E3D_X_Carriage.stl, Y Belt Holder_ABS.stl]
2015-06-18 Updated X Carriage to repair some alignment issues. Changed mounting screw holes from M3 to M4 as it seems easier to obtain long M4 screws. Updated X Carriage Idler to align better with the hobbed bo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
    [Ekstruder_X_Carriage_LM10UU_E3D-V6-Universal.stl, Extruder_Idler_for_Ekstruder_X_Carriage.stl, Prox_Sensor_Mount.stl]
2015-07-17 Adjusted hole position to fix alignment issues.
    [10mm_Z_Smooth_Rod_Holder_Upper_Left.stl, 10mm_Z_Smooth_Rod_Holder_Upper_Right.stl]
2015-08-18 1.) Fixed normals on Hotend Mount brick 2.) Renamed Prox_Sensor_Mount to 18mm_Prox_Sensor_Mount 3.) Added 12mm_Prox_Sensor_Mount file (as you never know what you are going to receive from ebay)
    [12mm_Prox_Sensor_Mount.stl, 18mm_Prox_Sensor_Mount.stl, Extruder_Hotend_Mount_for_E3D_X_Carriage.stl]
2015-12-02 Adapted X axis mounts, Motor End and Idler End, to suit 8mm Lead Screw and Nut.
    [8mm_LEAD_SCREW_X_Idler_End_Mount_1_Off.stl, 8mm_LEAD_SCREW_X_Motor_End_Mount_1_Off.stl]
2015-12-02 Correction of hole diameter of screw throughway.
    [8mm_LEAD_SCREW_X_Idler_End_Mount_1_Off.stl]
2015-12-15 add code to complete x_motor_mount
    I broke a lot of the parts out into modules for re-use, and the config
    file is slightly different from the original. I left the config for this
    is separate from the standard config. It is in with all the other
    include files. This commit is for issue 14.
    [X_Motor_Mount_1_Off.scad, configuration.scad, nemaMount.scad, polyarc.scad, xBacker.scad]
2015-12-15 Update code with re-written modularized code
    Re-wrote a large portion of the scad files to improve modularity and
    parametric nature from the config files. I am sure there are a few
    things that could still use tweaking but these should generally produce
    all the components needed in the BOM properly. Yes I renamed the files
    and am a jerk for doing it, sorry.
    [90_corner_inner_6_off.scad, Wades_Gears.scad, X_Motor_Mount_1_Off.scad, X_bar_clamp_2_off.scad, X_idler_1_off.scad, Y_Bearing_Holder_LM8UU_3_Off.scad, Y_Belt_Block_1_Off.scad, Y_Idler_1_Off.scad]
2016-01-02 MODIFIED: Jason's Mods X Carriage - Added supports in areas where needed so you do not have to turn on supports in your slicer ADDED: Revamp of the Z Axis drive to support 8mm Lead screw to improve Z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
    [10mm_Z_Axis_Top_Motor_Mounts.stl, 8mm_LEAD_SCREW_X_Idler_End_Mount_1_Off.stl, 8mm_LEAD_SCREW_X_Motor_End_Mount_1_Off.stl, 8mm_Leadscrew_Guides_Bottom_End.stl, 8mm_Leadscrew_Guides_Top_End.stl, 8mm_Leadscrew_X_Axis_Idle_End.stl, 8mm_Leadscrew_X_Axis_Motor_End.stl, Ekstruder_X_Carriage_LM10UU_E3D-V6-Universal.stl]
2016-01-17 some new files
    [Extruder_X_Carriage_Combo_LM10UU.SLDPRT]
2018-02-04 Add files via upload
    New x carriage
    [Extruder_X_Carriage_Combo_LM10UU_E3Dv6_and_J-head.STL]
